candeiassantiago393-spec/PAP/elevador/hardware/README.md

# Hardware — Elevador

Documentação física do protótipo: componentes, esquemas e mecânica.

| Pasta | Conteúdo |
|---|---|
| [bom/](bom/) | Bill of Materials — lista de componentes |
| [esquemas/](esquemas/) | Esquemas elétricos (KiCad, Fritzing, PDF) |
| [mecanica/](mecanica/) | Estrutura madeira, cabine adaptada, tambor, fixações |

## Estado

| Área | Estado |
|---|---|
| BOM documentado | Parcial — ver [bom/componentes.md](bom/componentes.md) |
| Esquemas formais | [ELV-SCH-001/002](esquemas/) |
| Estrutura mecânica | Madeira + recipiente adaptado — [mecanica/](mecanica/) |
| Fotos mecânica | Pendente — [mecanica/imagens/](mecanica/imagens/) |

## Compras

Faturas e justificação: [docs/compras/](../../docs/compras/)

## Navegação

| | |
|--|--|
| Elevador | [../README.md](../README.md) |
| Maquete | [../maquete/ESTADO_ATUAL.md](../maquete/ESTADO_ATUAL.md) |
| Pinagem | [../documentacao/pinagem.md](../documentacao/pinagem.md) |
| Índice repo | [../../docs/INDICE_REPOSITORIO.md](../../docs/INDICE_REPOSITORIO.md) |
