candeiassantiago393-spec/PAP/elevador/maquete/README.md

# Maquete Física — Elevador

Registo visual e estado da montagem do protótipo real.

## Conteúdo

| Pasta | Uso |
|---|-----|
| [imagens/fotos/](imagens/fotos/) | Fotografias da maquete |
| [imagens/videos/](imagens/videos/) | Vídeos de progresso |
| [ESTADO_ATUAL.md](ESTADO_ATUAL.md) | Estado detalhado e próximos passos |

## Vídeos (2026-06-22)

| Ficheiro | Descrição |
|---|---|
| [2026-06-22_maquete_oled_displays_teste.mp4](imagens/videos/2026-06-22_maquete_oled_displays_teste.mp4) | 4 displays OLED testados na estrutura |
| [2026-06-22_maquete_botoes_leds_exteriores.mp4](imagens/videos/2026-06-22_maquete_botoes_leds_exteriores.mp4) | Botões + LEDs exteriores — **piso 3 com falha** |
| [2026-06-22_maquete_botoes_leds_displays.mp4](imagens/videos/2026-06-22_maquete_botoes_leds_displays.mp4) | Integração geral (WhatsApp) |

## Fotos

| Ficheiro | Descrição |
|---|---|
| [2026-06-22_guias_cabos_argolas.png](imagens/fotos/2026-06-22_guias_cabos_argolas.png) | Argolas brancas + braçadeiras como guias de cabo |

## Próximas capturas

- Sensores Hall A3144 instalados
- Motor + tambor integrados no shaft
- Vista geral do poço completo
- Correção botão/LED 3.º andar (evidência depois)

## Estado detalhado

[ESTADO_ATUAL.md](ESTADO_ATUAL.md)

## Navegação

| | |
|--|--|
| Elevador | [../README.md](../README.md) |
| Mecânica / motor | [../hardware/mecanica/](../hardware/mecanica/) |
| Apresentação | [../../docs/APRESENTACAO_CURSOR.md](../../docs/APRESENTACAO_CURSOR.md) |
| Etapa E08 | [../../docs/ETAPAS/relatorios/E08_montagem_maquete.md](../../docs/ETAPAS/relatorios/E08_montagem_maquete.md) |
