candeiassantiago393-spec/PAP/logicas_extras/codigo_predio/documentacao/README.md

# Documentação — Código Porta Prédio

| Ficheiro | Conteúdo |
|---|---|
| [funcionamento.md](funcionamento.md) | Fluxo PIN, servo, serial |
| [pinagem.md](pinagem.md) | Ligações Arduino Uno |
| [fluxogramas.md](fluxogramas.md) | Diagramas de fluxo — **por fazer** |

## Navegação

| | |
|--|--|
| Módulo | [../README.md](../README.md) |
