candeiassantiago393-spec/PAP/logicas_extras/estendal_inteligente/documentacao/README.md

# Documentação — Estendal Inteligente

| Ficheiro | Conteúdo |
|---|---|
| [funcionamento.md](funcionamento.md) | Lógica chuva → servo |
| [pinagem.md](pinagem.md) | Ligações Arduino Uno |
| [fluxogramas.md](fluxogramas.md) | Diagramas de fluxo — **por fazer** |

## Navegação

| | |
|--|--|
| Módulo | [../README.md](../README.md) |
