candeiassantiago393-spec/PAP/logicas_extras/estendal_inteligente/simulacao/README.md

# Simulação — Estendal Inteligente

Projecto Wokwi: [wokwi/](wokwi/)

## Compilar

```bash
cd logicas_extras/estendal_inteligente/simulacao/wokwi
python -m platformio run
```

Stop + Start no Wokwi após compilar.

## Teste

Mudar o slide switch para ON → servo recolhe → espera 8 s → reabre.

## Navegação

| | |
|--|--|
| Módulo | [../../README.md](../../README.md) |
