candeiassantiago393-spec/PAP/elevador/hardware/mecanica/imagens/README.md

# Imagens — Mecânica

| Ficheiro | Descrição | Data |
|---|---|---|
| [2026-06-22_motor_nema17_tambor_correia.png](2026-06-22_motor_nema17_tambor_correia.png) | NEMA 17 bipolar, correia dentada, tambor como polia (suporte metálico) | 2026-06-22 |

Motor cedido pelo professor (reutilizável). Testado na bancada com L298N — integração no shaft da maquete pendente.

## Por adicionar

- Motor montado no topo do poço
- Cabo de aço na cabine
- Fixação Hall por piso

## Navegação

| | |
|--|--|
| Mecânica | [../README.md](../README.md) |
| Maquete | [../../../maquete/ESTADO_ATUAL.md](../../../maquete/ESTADO_ATUAL.md) |
