candeiassantiago393-spec/PAP/elevador/hardware/mecanica/stl/README.md

# STL — Plano inicial (não utilizado)

> **Nota:** Este diretório reflecte o **plano inicial** de impressão 3D da cabine.  
> Na implementação final, a estrutura foi feita **à mão com madeira** e a cabine com um **recipiente adaptado**.  
> Ver [../README.md](../README.md) e [../imagens/](../imagens/) para o registo actual.

## Plano original (referência)

| Ficheiro | Descrição | Estado |
|---|---|---|
| `cabine_v1.stl` | Corpo da cabine | Não aplicável |
| `guia_cabine.stl` | Guias no shaft | Não aplicável |
| `suporte_hall.stl` | Fixação sensores | Não aplicável |

Mantido para histórico do projecto — caso no futuro se queira uma peça impressa (ex.: suporte Hall).

## Ligação

- [E08 — Montagem maquete](../../../../docs/ETAPAS/relatorios/E08_montagem_maquete.md)
- [Dimensionamentos_motor.docx](../../../../docs/relatorios/Dimensionamentos_motor.docx)
