candeiassantiago393-spec/PAP/elevador/maquete/imagens/fotos/README.md

# Fotos — Maquete

| Ficheiro | Descrição | Data |
|---|---|---|
| [2026-06-22_guias_cabos_argolas.png](2026-06-22_guias_cabos_argolas.png) | Argolas brancas parafusadas à estrutura + braçadeiras para guiar cabos | 2026-06-22 |

## Por adicionar

- Vista geral do shaft
- Hall A3144 por piso
- Motor/tambor integrado no topo
- Cabine + íman

## Navegação

| | |
|--|--|
| Maquete | [../../README.md](../../README.md) |
| Vídeos | [../videos/](../videos/) |
