candeiassantiago393-spec/PAP/logicas_extras/codigo_predio/simulacao/wokwi/README.md

# Wokwi — Cofre código secreto

Abrir **esta pasta** como raiz do projeto Wokwi no Cursor.

| Ficheiro | Uso |
|---|-----|
| `sketch.ino` | Firmware |
| `diagram.json` | Circuito virtual |
| `wokwi.toml` | Configuração Wokwi |
| `libraries.txt` | Servo, Keypad |

`F1` → **Wokwi: Start Simulator**
