candeiassantiago393-spec/PAP/docs/ETAPAS/relatorios/E12_logicas_extras.md

# E12 — Lógicas Extras do Prédio Inteligente

| Campo | Valor |
|---|---|
| **Estado** | Em curso (codigo_predio + painel ecra) |
| **Código** | `logicas_extras/` |

## Objetivo

Subsistemas do prédio além do elevador: segurança, RFID, meteorologia, porta, toldo, etc.

## Módulos planeados

| Módulo | Estado |
|---|---|
| **Código prédio** | Simulação Wokwi — [logicas_extras/codigo_predio/](../../logicas_extras/codigo_predio/) |
| Segurança | Inicial |
| Painéis controlo | **Simulação Wokwi** — [paineis_controlo/caixa_ecra](../../logicas_extras/paineis_controlo/simulacao/wokwi/) |
| Meteorologia | **Funcional no painel ecra** — [meteorologia](../../logicas_extras/meteorologia/) (KY-015, ecrãs AMBIENTE/GRÁFICO) |
| Porta prédio + código | Inicial (relacionado com codigo_predio) |
| RFID por andar | Inicial |
| Toldo automático (chuva) | Inicial |

## Prioridade

Após conclusão do elevador (E10).

## O que foi feito

### Código prédio — teclado + servo (Wokwi)

- Protótipo funcional: teclado 3×4, validação PIN, servo, LEDs e buzzer
- Código correcto de demonstração: `1904`
- Export integrado em `logicas_extras/codigo_predio/simulacao/wokwi/`
- Link: https://wokwi.com/projects/462220624733136897

Relacionado com a porta do prédio (mesma lógica de acesso por código).

### Painel ESP32 — caixa ecra (Wokwi)

- ESP32 + OLED SSD1306 — 6 ecrãs: HOME, ambiente (KY-015), movimento (PIR), plantas/estufa, gráfico temp, QR Instagram
- Modo feira (rotação auto), alertas Telegram opcionais
- Export: `logicas_extras/paineis_controlo/simulacao/wokwi/`
- PlatformIO: `logicas_extras/paineis_controlo/real/caixa_ecra/`
- Origem: projeto local **ecra** (candeias.dev)

Cobre [meteorologia](../../logicas_extras/meteorologia/) (ecrãs AMBIENTE + GRÁFICO) e [segurança](../../logicas_extras/seguranca/) (ecrã MOVIMENTO) na demonstração.

Documentação meteorologia: [funcionamento.md](../../logicas_extras/meteorologia/documentacao/funcionamento.md).

_(Outros módulos a documentar à medida que evoluem.)_

## Compras relacionadas

| Fatura | Total | Componentes |
|---|---|---|
| [2026EC1403323](../compras/faturas_mauser/2026EC1403323.md) | 29,62 € | ESP32, teclado, RFID, OLED protótipo |
| [2026EC1409725](../compras/faturas_mauser/2026EC1409725.md) | 47,18 € | T-Camera S3 (câmara + PIR) |

Ver [índice Mauser](../compras/faturas_mauser/_indice.md).
