candeiassantiago393-spec/PAP/elevador/maquete/ESTADO_ATUAL.md

# Estado Atual da Maquete

> Última atualização: 2026-07-06

## Fase do projeto

**Integração física na maquete** — I/O exterior e displays montados; motor testado em **bancada** (ainda não integrado na estrutura).

```text
[✓] Programar / projetar
[✓] Simulação virtual (v01–v06)
[✓] Testes de bancada (botões, LEDs, OLED, motor+L298N, Hall pendente teste casa)
[→] Montagem na maquete (I/O + cablagem)     ← ESTAMOS AQUI
[ ] Sensores Hall + íman na cabine
[ ] Motor + tambor na maquete
[ ] Testes sistema completo
[ ] Acabamentos (ventoinha L298N, porta/interiores se aplicável)
[ ] Decoração e visual moderno (papel autocolante, miniaturas interiores)
```

---

## Componentes montados na maquete

| Componente | Qtd | Estado | Notas |
|---|-----|---|---|
| Botões pedido exterior | 4 | Montado | **Piso 3 com falha** — ver [DIFICULDADES](../../docs/DIFICULDADES.md) |
| LEDs pedido exterior | 4 | Montado | Piso 3 a investigar (mau contacto?) |
| Displays OLED SH1106 | 4 | Montado | Testados em vídeo |
| Multiplexador TCA9548A | 1 | Montado | — |
| Guias de cabos (argolas) | várias | Montado | Braçadeiras + argolas brancas na estrutura |
| Estrutura madeira + cabine | 1 | Montado | Recipiente adaptado |

### Ainda fora da maquete (mas disponíveis)

| Componente | Estado |
|---|---|
| Motor NEMA 17 + tambor/polia + correia | Montagem mecânica feita; **testado na bancada** com 12 V; por integrar no shaft |
| Driver L298N | Testado na bancada (cedido tutor Manuel Queiroz) |
| Sensores Hall **A3144** ×4 | Montados — D7, D8, D11, D12 |
| Firmware maquete | [codigo_final_3_0_maquete/ext_porta](../real/codigo_final_3_0_maquete/ext_porta/) |
| Ventoinha 40 mm L298N | **Não comprada** |
| Botões/LEDs interiores | **Por decidir** — possível só apresentação virtual |
| Permissiva porta (D22) | **Chave deslizante** montada |

---

## Próximos passos (ordem)

1. **Testar Hall A3144** — `testes/bancada/hall_diag/` e `hall_sequencia/`
2. Confirmar cabos **OUT** dos sensores piso 1 e 2 (D7, D8)
3. Integrar **motor + tambor** no topo/shaft da maquete
4. Corrigir **botão/LED 3.º andar** (testes de continuidade)
5. Ventoinha no L298N (quando comprada)
6. Decidir se porta e botões interiores ficam físicos ou só na simulação Wokwi
7. **Sábado 2026-07-11:** comprar decorações — papel autocolante para revestimento exterior (visual moderno do prédio), bonecos e miniaturas para o interior dos apartamentos

---

## Decoração e acabamento visual (planeado)

| Item | Objetivo | Quando |
|---|---|---|
| Papel autocolante | Fachada e paredes com aspeto moderno (substituir madeira à vista) | Compra **sábado 11 jul** |
| Bonecos / figuras miniatura | Interior dos pisos — dar vida aos apartamentos na maquete | Compra **sábado 11 jul** |
| Outras decorações | Detalhes de ambiente (mobiliário em miniatura, plantas, etc.) | Compra **sábado 11 jul** |

> Aplicar decoração **após** cablagem e testes eléctricos principais, para não danificar acabamentos.

---

## Convenção de pisos

| Nome na maquete | Piso lógico firmware |
|---|---|
| **Rés-do-chão / 1.º andar** | Piso 1 (Hall **D7**, botão D2, etc.) |
| 2.º–4.º andar | Pisos 2–4 |

---

## Evidências (fotos e vídeos)

| Ficheiro | Descrição |
|---|---|
| [oled_displays_teste.mp4](imagens/videos/2026-06-22_maquete_oled_displays_teste.mp4) | 4 displays OLED a serem testados |
| [botoes_leds_exteriores.mp4](imagens/videos/2026-06-22_maquete_botoes_leds_exteriores.mp4) | Botões + LEDs exteriores — **piso 3 com problema** |
| [guias_cabos_argolas.png](imagens/fotos/2026-06-22_guias_cabos_argolas.png) | Argolas brancas + braçadeiras como guias de cabo |
| [motor_tambor_correia.png](../hardware/mecanica/imagens/2026-06-22_motor_nema17_tambor_correia.png) | NEMA 17, correia dentada, tambor como polia |

---

## Diferenças simulação ↔ maquete

| Aspeto | Wokwi v06 | Maquete |
|---|---|---|
| Driver | A4988 | L298N (D9, D33, D31, D32) |
| OLED | SSD1306 | SH1106 + TCA9548A |
| Sensor piso | Interruptor | Hall **A3144** (LOW = íman) |
| Motor | Stepper sim | NEMA 17 bipolar (4 fios) |
| Porta / interiores | Simulados | Possivelmente **só virtuais** na apresentação |

Pinagem completa: [documentacao/pinagem.md](../documentacao/pinagem.md)

---

## Notas de montagem

- 2026-06-22: I/O exterior + OLEDs integrados na estrutura madeira.
- Cablagem organizada com **braçadeiras** e **argolas** (tipo berço) parafusadas à maquete.
- Motor + tambor: conjunto mecânico pronto; alimentação 12 V validada **na bancada**, não no shaft.
- Lógicas extras (codigo_predio, ecra, toldo, RFID): **após elevador funcional** na maquete.
- 2026-07-06: Botões novos chegaram; testes de lógica do elevador em curso.
- 2026-07-11 (sábado): compra planead de papel autocolante, bonecos e decorações miniatura para acabamento visual da maquete.
