candeiassantiago393-spec/PAP/docs/compras/faturas_mauser/2026EC1403323.md

# Fatura 2026EC1403323

| Campo | Valor |
|---|---|
| **Fatura** | FT V201.04/26017707 |
| **Encomenda** | 2026EC1403323 |
| **Data** | 2026-02-06 |
| **Total** | **29,62 €** |
| **Etapa** | [E12 — Lógicas extras](../../ETAPAS/relatorios/E12_logicas_extras.md) |
| **PDF** | [2026EC1403323.pdf](2026EC1403323.pdf) |

## Itens

| Cód. | Designação | Qtd | Preço | Total | Módulo previsto |
|---|---|-----|---|---|---|
| 095-4900 | NodeMCU ESP32 USB-C | 1 | 9,39 € | 9,39 € | Lógicas extras / IoT |
| 096-4642 | Teclado matricial 3×4 | 1 | 4,07 € | 4,07 € | [porta_predio](../../../logicas_extras/porta_predio/) |
| 096-7806 | OLED 0,96" I2C | 1 | 3,83 € | 3,83 € | Protótipo / testes |
| 096-7946 | Placa protótipo photoshield | 1 | 2,36 € | 2,36 € | Bancada extras |
| 096-8517 | Leitor RFID RC522 13,56 MHz | 1 | 1,59 € | 1,59 € | [rfid](../../../logicas_extras/rfid/) |
| PORTES | Encargos logísticos | 1 | 2,84 € | 2,84 € | — |

## Justificação — componente e função

| Cód. | Componente | Função | Detalhe |
|---|---|---|---|
| 095-4900 | ESP32 NodeMCU | MCU Wi-Fi/BT para subsistemas do prédio | [logicas_extras.md](../justificacao/logicas_extras.md#módulo-nodemcu-esp32-usb-c-095-4900) |
| 096-4642 | Teclado 3×4 | Código de acesso à porta do prédio | [logicas_extras.md](../justificacao/logicas_extras.md#teclado-matricial-de-membrana-3×4-096-4642) |
| 096-7806 | OLED 0,96" | Display de protótipo para módulos extras | [logicas_extras.md](../justificacao/logicas_extras.md#ecrã-oled-096-128×64-i2c-096-7806) |
| 096-7946 | Photosheild | Bancada de prototipagem rápida | [logicas_extras.md](../justificacao/logicas_extras.md#placa-protótipo-photoshield-096-7946) |
| 096-8517 | RFID RC522 | Leitura de cartões de acesso | [logicas_extras.md](../justificacao/logicas_extras.md#módulo-leitor-rfid-rc522-1356-mhz-096-8517) |

## Ligação ao projeto

- [logicas_extras/](../../../logicas_extras/)
