candeiassantiago393-spec/PAP/docs/compras/faturas_mauser/2026EC1409725.md

# Fatura 2026EC1409725

| Campo | Valor |
|---|---|
| **Fatura** | FT V201.04/26021406 |
| **Encomenda** | 2026EC1409725 |
| **Data** | 2026-02-13 |
| **Total** | **47,18 €** |
| **Etapa** | [E12 — Lógicas extras](../../ETAPAS/relatorios/E12_logicas_extras.md) |
| **PDF** | [2026EC1409725.pdf](2026EC1409725.pdf) |

## Itens

| Cód. | Designação | Qtd | Preço | Total | Módulo previsto |
|---|---|-----|---|---|---|
| 095-5977 | LILYGO T-Camera S3 (ESP32 + câmara 5 MP + PIR) | 1 | 31,46 € | 31,46 € | [seguranca](../../../logicas_extras/seguranca/) |
| 095-5979 | Caixa protetora T-Camera S3 | 1 | 3,29 € | 3,29 € | Segurança |
| 095-5980 | Cabo PH2.0 → DuPont fêmea | 1 | 0,77 € | 0,77 € | Ligação |
| PORTES | Encargos logísticos | 1 | 2,84 € | 2,84 € | — |

## Justificação — componente e função

| Cód. | Componente | Função | Detalhe |
|---|---|---|---|
| 095-5977 | T-Camera S3 | Câmara + PIR para vigilância do prédio | [logicas_extras.md](../justificacao/logicas_extras.md#placa-lilygo-t-camera-s3--esp32--câmara-5-mp--pir-095-5977) |
| 095-5979 | Caixa T-Camera | Proteção mecânica do módulo | [logicas_extras.md](../justificacao/logicas_extras.md#caixa-protetora-t-camera-s3-095-5979) |
| 095-5980 | Cabo PH2.0 | Ligação periféricos da câmara | [logicas_extras.md](../justificacao/logicas_extras.md#cabo-ph20--dupont-fêmea-095-5980) |

## Ligação ao projeto

- [logicas_extras/seguranca/](../../../logicas_extras/seguranca/)
