candeiassantiago393-spec/PAP/docs/compras/faturas_mauser/2026EC1454381.md

# Fatura 2026EC1454381

| Campo | Valor |
|---|---|
| **Fatura** | FT V201.04/26047273 |
| **Encomenda** | 2026EC1454381 |
| **Data** | 2026-04-06 |
| **Total** | **46,79 €** |
| **Etapa** | [E07 — Testes de bancada](../../ETAPAS/relatorios/E07_testes_bancada.md) |
| **PDF** | [2026EC1454381.pdf](2026EC1454381.pdf) |

## Itens

| Cód. | Designação | Qtd | Preço | Total |
|---|---|-----|---|---|
| 035-0873 | Fonte industrial 12 VDC 5 A 60 W — Orno OR-ZL-1633 | 1 | 7,72 € | 7,72 € |
| 095-0403 | Kit 525 resistências 1/4 W 1% | 1 | 5,24 € | 5,24 € |
| 096-8737 | OLED 1,3" I2C branco (Arduino) | 4 | 5,56 € | 22,24 € |
| PORTES | Encargos logísticos | 1 | 2,84 € | 2,84 € |

## Justificação — componente e função

Cada item com a sua função no sistema. Detalhe completo em [justificacao/](../justificacao/).

| Cód. | Componente | Função | Justificação |
|---|---|---|---|
| 035-0873 | Fonte Orno 12 V 5 A | Alimentar motor (L298N) e malha de potência | [elevador.md](../justificacao/elevador.md#fonte-de-alimentação-industrial-12-vdc-5-a-60-w--orno-035-0873) |
| 095-0403 | Kit resistências | Limitar corrente em LEDs e circuitos auxiliares | [elevador.md](../justificacao/elevador.md#conjunto-525-resistências-14-w-1-095-0403) |
| 096-8737 | OLED 1,3" ×4 | Mostrar piso, fila, estado e emergência por andar | [elevador.md](../justificacao/elevador.md#módulo-ecrã-oled-13-i2c-branco-096-8737--×4-unidades) |

## Ligação ao projeto

- Elevador: fonte + OLEDs → [elevador/real/](../../../elevador/real/)
- Testes: [elevador/testes/bancada/](../../../elevador/testes/bancada/)
