candeiassantiago393-spec/PAP/docs/compras/faturas_mauser/_indice.md

# Índice — Faturas Mauser

| # | Encomenda | Fatura | Data | Total | Etapa | Ficheiro |
|---|---|---|---|---|---|---|
| 1 | [2026EC1403323](2026EC1403323.md) | FT V201.04/26017707 | 2026-02-06 | **29,62 €** | E12 | [PDF](2026EC1403323.pdf) |
| 2 | [2026EC1409725](2026EC1409725.md) | FT V201.04/26021406 | 2026-02-13 | **47,18 €** | E12 | [PDF](2026EC1409725.pdf) |
| 3 | [2026EC1454381](2026EC1454381.md) | FT V201.04/26047273 | 2026-04-06 | **46,79 €** | E07 | [PDF](2026EC1454381.pdf) |
| 4 | Loja Corroios | FR V602.04/26021664 | 2026-06-15 | **7,88 €** | E08 | [recibo](2026-06-15_FR26021664_recibo_mauser_corroios.png) |

**Total documentado:** 131,47 €

---

## Por etapa do projeto

### E07 — Bancada
| Componente | Código | Qtd | Valor | Fatura |
|---|---|-----|---|---|
| Fonte 12 VDC 5 A 60 W (Orno) | 035-0873 | 1 | 7,72 € | [2026EC1454381](2026EC1454381.md) |
| Kit 525 resistências 1/4 W | 095-0403 | 1 | 5,24 € | [2026EC1454381](2026EC1454381.md) |
| OLED 1,3" I2C branco | 096-8737 | 4 | 22,24 € | [2026EC1454381](2026EC1454381.md) |

### E08 — Maquete
| Componente | Código | Qtd | Valor | Fatura |
|---|---|-----|---|---|
| Fio cobre multifilar preto 25 m | 016-0210 | 1 | 3,55 € | [recibo Corroios](2026-06-15_FR26021664_recibo_mauser_corroios.png) |
| Fio cobre multifilar branco 25 m | 016-0211 | 1 | 2,56 € | [recibo Corroios](2026-06-15_FR26021664_recibo_mauser_corroios.png) |
| Manga termorretrátil amarela 1 m | 096-1690 | 1 | 0,30 € | [recibo Corroios](2026-06-15_FR26021664_recibo_mauser_corroios.png) |

### E12 — Lógicas extras
| Componente | Código | Qtd | Valor | Fatura |
|---|---|-----|---|---|
| NodeMCU ESP32 USB-C | 095-4900 | 1 | 9,39 € | [2026EC1403323](2026EC1403323.md) |
| Teclado matricial 3×4 | 096-4642 | 1 | 4,07 € | [2026EC1403323](2026EC1403323.md) |
| OLED 0,96" I2C (protótipo) | 096-7806 | 1 | 3,83 € | [2026EC1403323](2026EC1403323.md) |
| Placa protótipo photoshield | 096-7946 | 1 | 2,36 € | [2026EC1403323](2026EC1403323.md) |
| Leitor RFID RC522 | 096-8517 | 1 | 1,59 € | [2026EC1403323](2026EC1403323.md) |
| LILYGO T-Camera S3 (ESP32 + câmara) | 095-5977 | 1 | 31,46 € | [2026EC1409725](2026EC1409725.md) |
| Caixa T-Camera S3 | 095-5979 | 1 | 3,29 € | [2026EC1409725](2026EC1409725.md) |
| Cabo PH2.0 → DuPont | 095-5980 | 1 | 0,77 € | [2026EC1409725](2026EC1409725.md) |

---

## Pendente

- [ ] Mais faturas Mauser (jumpers, ponteiras, motor, L298N, Hall…)
- [x] Justificações técnicas — [justificacao/](../justificacao/) (componente + função)
