candeiassantiago393-spec/PAP/docs/relatorios/Dimensionamentos_motor.docx

Relatório Técnico Académico

Projeto de Protótipo de Elevador e Prédio Inteligente (4 Pisos)

1. Introdução e Especificações do Sistema

O presente relatório técnico tem como objetivo apresentar a memória descritiva e o dimensionamento mecânico e elétrico de um protótipo funcional de elevador integrado num edifício inteligente de quatro pisos, com controlo através de microcontrolador Arduino Mega 2560.

1.1 Premissas Físicas do Sistema

O sistema foi concebido com base nas seguintes especificações:

- Número de pisos: 4
- Curso total do elevador: 80 cm
- Altura entre pisos: 20 cm
- Massa máxima (carga desequilibrada): 0,6 kg
- Velocidade linear de operação: 0,10 m/s
- Condição crítica: ausência de contrapeso

Estas condições representam o pior cenário operacional, garantindo a máxima robustez no dimensionamento do sistema.

1.2 Arquitetura de Alimentação

O sistema utiliza uma arquitetura híbrida com separação funcional entre potência e lógica:

- Malha de Lógica:
  - Tensão: 5V DC
  - Alimentação via porta USB / barramento do Arduino Mega
- Malha de Potência:
  - Tensão: 12V DC
  - Fonte industrial de colmeia: Orno 12V, 5A (60W) — Modelo OR-ZL-1633

📌 Nota Técnica Importante:
Apesar da separação funcional das fontes, é utilizado obrigatoriamente um GND comum (referência de massa interligada entre o polo negativo da fonte Orno e o pino GND do Arduino). Esta interligação de massas é obrigatória para estabelecer o mesmo referencial nulo entre os dois circuitos. Sem este ponto comum, os transístores internos do circuito integrado L298N não conseguiriam interpretar corretamente os sinais de nível lógico Alto (5V) e Baixo (0V) provenientes dos pinos digitais do Arduino Mega, resultando em falhas de comutação e comportamento errático do motor.

2. Dimensionamento Mecânico (Física do Movimento)

2.1 Cálculo da Força Peso

A força exercida pela carga para vencer a gravidade é determinada pela equação fundamental:

F = m * g

Onde:

- m = 0,6 kg
- g = 9,81 m/s^2 (aceleração gravitacional padrão da Terra, baseada na massa e no raio médio do planeta)

F = 0,6 * 9,81 = 5,886 N

2.2 Potência Mecânica Útil

A potência mecânica instantânea necessária para o deslocamento vertical é:

P_u = F * v

P_u = 5,886 * 0,10 = 0,5886 W

Aplicando um Fator de Segurança (FS = 2,0) para mitigar o atrito estático nas calhas guia verticais e a inércia no arranque:

P_nominal = 0,5886 * 2 = 1,1772 W

2.3 Cálculo do Binário no Tambor

A relação entre a força peso e o torque necessário no eixo de tração é dada por:

T = F * r

Onde:

- r = 0,02 m (raio correspondente ao tambor de 4 cm diâmetro)

T = 5,886 * 0,02 = 0,11772 Nm

Efetuando a conversão para a unidade comercial padrão de motores de passo (1 Nm = 10,197 kgf.cm):

T = 0,11772 * 10,197 = 1,20 kgf.cm

Aplicando o Fator de Segurança (FS = 2,0):

T_seguranca = 2,40 kgf.cm

2.4 Justificação do Motor NEMA 17

O motor selecionado (NEMA 17 híbrido industrial recuperado) apresenta um torque típico de retenção entre 3,5 a 4,5 kgf·cm.

✅ Conclusão Técnica:

- O motor excede o requisito mínimo de segurança calculado (2,40 kgf·cm).
- Garante uma margem de segurança superior a 45% diretamente no eixo.
- O conjunto mecânico inclui uma correia síncrona que fornece uma redução mecânica adicional entre o eixo do motor e o tambor. Isto funciona como uma caixa de redução que multiplica o torque efetivo e reduz o esforço do motor.

📌 Nota Prática de Comissionamento (Identificação de Bobinas):
Por se tratar de um motor bipolar de quatro fios recuperado de equipamento industrial, a identificação dos pares de bobinas (Fase A e Fase B) deve ser realizada por ensaio de curto-circuito indutivo. Ao unir as extremidades de dois fios aleatórios e rodar manualmente o eixo do motor, a ocorrência de uma resistência mecânica severa (efeito de travagem por indução magnética) valida que esses fios pertencem à mesma fase, devendo ser conectados respetivamente aos bornes OUT1/OUT2 (Fase A) ou OUT3/OUT4 (Fase B) do driver L298N.

3. Dimensionamento Elétrico e Análise de Energia

3.1 Malha de Potência (12V DC)

Consumo do Motor através do estágio de potência:

- Corrente nominal por fase: 1,5 A
- Comutação: duas fases ativas simultaneamente (padrão de passos do código)

P = V * I = 12 * 1,5 = 18 W

3.2 Validação da Fonte de Alimentação

A fonte escolhida foi o modelo industrial Orno OR-ZL-1633.

Parâmetro | Valor
Tensão | 12V DC (Regulada)
Corrente Máxima | 5 A
Potência Máxima | 60 W

Cálculo da margem de capacidade da fonte (Folga):

Folga = 60W / 18W = 3,33

✅ Conclusão:
A fonte disponibiliza mais de 300% de capacidade em relação ao consumo do motor, operando num regime térmico confortável e oferecendo total imunidade a quedas de tensão causadas por picos de corrente no arranque.

3.3 Malha de Lógica (5V DC)

Análise do somatório de consumo dos periféricos associados ao Arduino Mega 2560:

Dispositivo / Periférico | Corrente Estimada (mA)
Arduino Mega 2560 (Placa) | 50 mA
4x Displays OLED SH1106 (4 * 20 mA) | 80 mA
LEDs Indicadores (Média de acesos) | 75 mA
Sensores Hall de Piso e Porta (5 * 5 mA) | 25 mA
Buzzer Piezoelétrico (Pico ativo) | 30 mA
Total da Malha de Lógica | 260 mA

Cálculo da potência da malha lógica:

P = 5V * 0,26A = 1,3 W

✅ Conclusão:
A corrente total exigida (260 mA) é substancialmente inferior ao limite standard fornecido por uma porta USB de computador (500 mA). O barramento de 5V do Arduino Mega possui capacidade para estabilizar todos os componentes com segurança.

3.4 Análise Termodinâmica da Energia

📌 Importante:
A potência mecânica útil (1,18 W) jamais deve ser somada à potência elétrica total das fontes (19,5 W). Na física, a potência mecânica é o resultado direto da conversão da energia elétrica disponível.

P_eletrica = P_mecanica + P_perdas

A diferença entre os 18W elétricos injetados na malha de potência e os 1,18W de trabalho mecânico útil representa a ineficiência do sistema, sendo totalmente dissipada sob a forma de calor nas bobinas do motor e nos semicondutores do driver.

4. Comportamento Térmico e Análise do Driver L298N

4.1 Limitações Tecnológicas

O circuito integrado L298N é baseado numa tecnologia de transístores bipolares de junção em configuração Darlington. Esta arquitetura antiga introduz uma resistência interna significativa, gerando uma queda de tensão interna estável entre 2V e 2,5V.

A tensão efetiva que chega aos terminais do motor é de:

V_motor = 12V - 2,5V = 9,5V

✅ Conclusão Técnica:
Apesar da perda de tensão, o motor mantém torque suficiente para a operação devido à leveza da cabine e ao auxílio da redução mecânica por correia.

4.2 Dissipação Térmica

Multiplicando a queda de tensão (2,5V) pela corrente nominal (1,5A), o chip gera uma dissipação contínua de:

P_perdas = 3.75 W

⚠️ Requisito Crítico de Segurança:
Para evitar que o driver ative a sua proteção térmica interna e desarme o elevador, é obrigatória a instalação de uma ventoinha (cooler) de arrefecimento ativo de 12V.

- Posicionamento: Fixada a 1 ou 2 cm de distância, soprando ar diretamente nas aletas do dissipador de alumínio do L298N.
- Ligação Elétrica: Conectada em paralelo diretamente nos bornes de entrada de potência (VCC e GND) do módulo L298N. Desta forma, o fluxo de ar inicia-se de forma automática assim que a fonte industrial Orno é ligada à tomada.

4.3 Gestão Inteligente de Energia via Software

Como estratégia de conservação energética e alívio térmico, o código fonte do Arduino implementa a função:

desligaBobinasMotor()

Esta função corta a corrente nas pontes H sempre que o elevador atinge o estado de paragem prolongada nos pisos (aguardando temporização ou novos comandos). Isto zera o consumo de corrente do motor em repouso, permitindo o arrefecimento rápido do driver L298N e prolongando a vida útil dos componentes.

5. Conclusões

O desenvolvimento deste estudo valida que o protótipo do prédio inteligente se encontra corretamente dimensionado:

- ✅ Mecânica: O binário exigido está acautelado pelo torque nativo do motor NEMA 17 e otimizado pela redução por correia.
- ✅ Elétrica: A fonte Orno de 60W trabalha com folga industrial superior a 300%, eliminando quaisquer riscos de sobrecarga.
- ✅ Lógica: A malha de controlo a 5V consome apenas 260mA, garantindo a estabilidade operacional do Arduino Mega e dos displays OLED.
- ✅ Térmica: As limitações térmicas do driver L298N foram totalmente mitigadas através da inclusão da ventoinha dedicada e da rotina de software para desligar as bobinas em repouso.
