candeiassantiago393-spec/PAP/docs/relatorios/Relatorio_Elevador_Inteligente.docx

Relatório Técnico Académico

Projeto de Protótipo de Elevador e Prédio Inteligente (4 Pisos)

1. Introdução e Especificações do Sistema

O presente relatório técnico tem como objetivo apresentar a memória descritiva e o dimensionamento mecânico e elétrico de um protótipo funcional de elevador integrado num edifício inteligente de quatro pisos, com controlo através de microcontrolador Arduino Mega 2560.

1.1 Premissas Físicas do Sistema

O sistema foi concebido com base nas seguintes especificações:

- Número de pisos: 4

- Curso total do elevador: 80 cm

- Altura entre pisos: 20 cm

- Massa máxima: 0,6 kg

- Velocidade linear: 0,10 m/s

- Condição crítica: ausência de contrapeso

1.2 Arquitetura de Alimentação

Sistema com separação entre lógica (5V) e potência (12V).

Nota Técnica Importante:

Apesar da separação funcional, é utilizado um GND comum.

Esta interligação de massas (GND Comum) é obrigatória para estabelecer o mesmo referencial nulo entre os dois circuitos. Sem este ponto comum, os transístores internos do circuito integrado L298N não conseguiriam interpretar corretamente os sinais de nível lógico Alto (5V) e Baixo (0V) provenientes dos pinos digitais do Arduino Mega, resultando em falhas de comutação e comportamento errático do motor.

2. Dimensionamento Mecânico

2.1 Força Peso

F = m · g = 0,6 × 9,81 = 5,886 N

2.2 Potência Mecânica

Pu = F · v = 0,5886 W

Pnominal ≈ 1,18 W

2.3 Torque

τ = 0,11772 Nm ≈ 1,20 kgf·cm

τ_segurança = 2,40 kgf·cm

2.4 Motor NEMA 17

Torque típico: 3,5 a 4,5 kgf·cm

Nota Prática de Comissionamento (Identificação de Bobinas): Por se tratar de um motor bipolar de quatro fios recuperado de equipamento industrial, a identificação dos pares de bobinas (Fase A e Fase B) deve ser realizada por ensaio de curto-circuito indutivo. Ao unir as extremidades de dois fios aleatórios e rodar manualmente o eixo do motor, a ocorrência de uma resistência mecânica severa valida que esses fios pertencem à mesma fase.

3. Dimensionamento Elétrico

3.1 Potência

P = 12 × 1,5 = 18 W

3.3 Lógica

Total ≈ 260 mA (1,3 W)

4. Comportamento Térmico

4.2 Dissipação

P ≈ 3–4 W

⚠️ Ventoinha deve ser ligada em paralelo diretamente nos bornes de entrada de potência (VCC e GND) do módulo L298N. Desta forma, o fluxo de ar inicia-se automaticamente.

5. Conclusões

Sistema validado e seguro.
