candeiassantiago393-spec/PAP/docs/README.md

# Documentação — PAP Prédio Inteligente

Índice central da documentação do repositório.

## Começar aqui

| Documento | Para quê |
|---|---|
| [INDICE_REPOSITORIO.md](INDICE_REPOSITORIO.md) | **Mapa completo** — todas as pastas interligadas |
| [CONTEXTO_PROJETO.md](CONTEXTO_PROJETO.md) | Histórico, versões, pinagem, estados |
| [ETAPAS/README.md](ETAPAS/README.md) | Cronologia E00–E12 com links ao código |
| [TASKS_PAP_SYNC.md](TASKS_PAP_SYNC.md) | Tasks do projeto (sync Candeias Control App) |
| [APRESENTACAO_CURSOR.md](APRESENTACAO_CURSOR.md) | Guia demo no Cursor (17 julho) |
| [DIFICULDADES.md](DIFICULDADES.md) | Problemas e soluções registados |

## Relatórios e especificação

| Pasta | Conteúdo |
|---|---|
| [relatorios/Relatorio_Especificacao_PAP_Predio_Inteligente_v4.pdf](relatorios/Relatorio_Especificacao_PAP_Predio_Inteligente_v4.pdf) | **Documento de referência do projeto final** — Relatório Técnico + DET v4.0, cobre elevador + lógicas extra + interfaces auxiliares |
| [relatorios/](relatorios/) | Restantes PDFs e DOCX (especificações parciais, dimensionamentos) |
| [ETAPAS/relatorios/](ETAPAS/relatorios/) | Relatório por fase do projeto |

## Compras

| Pasta | Conteúdo |
|---|---|
| [compras/](compras/) | Índice de faturas Mauser |
| [compras/justificacao/](compras/justificacao/) | Função de cada componente |
| [compras/faturas_mauser/_indice.md](compras/faturas_mauser/_indice.md) | Componente ↔ fatura ↔ etapa |

## Ligação ao código

| Área | Pasta |
|---|---|
| Elevador | [../elevador/](../elevador/) |
| Lógicas extras | [../logicas_extras/](../logicas_extras/) |
| Interface organização | [../interface/](../interface/) |

## Raiz do repo

[README.md](../README.md)
