candeiassantiago393-spec/PAP/logicas_extras/README.md

# Lógicas Extras — Prédio Inteligente

Subsistemas do prédio inteligente **além do elevador**.

## Módulos

| Pasta | Função | Estado |
|---|---|---|
| [cartoes_predio/](cartoes_predio/) | Cartões RFID — acesso por andar | Inicial |
| [central_de_controlo/](central_de_controlo/) | Caixa ESP32 OLED (ambiente, PIR, estufa, gás, fogo, sismo) | **Simulação Wokwi** |
| [codigo_predio/](codigo_predio/) | Código PIN porta prédio (teclado + servo) | **Simulação Wokwi** |
| [estendal_inteligente/](estendal_inteligente/) | Estendal por sensor de chuva | **Simulação Wokwi** |
| [legacy/](legacy/) | Versões antigas | — |

## Estrutura por módulo

```text
<nome_modulo>/
├── README.md           → visão geral do módulo
├── documentacao/       → funcionamento.md, pinagem.md, fluxogramas.md
├── simulacao/          → wokwi/ quando aplicável
├── real/               → montagem física: pinagem.md, notas, fotos/, código PlatformIO
└── testes/             → registo + código de bancada (PlatformIO)
    └── bancada/        → testes isolados por componente (quando aplicável)
```

## Registo diário (bancada)

| Data | Ficheiro |
|---|---|
| 2026-07-11 | [central_de_controlo/testes/bancada/REGISTO_2026-07-11.md](central_de_controlo/testes/bancada/REGISTO_2026-07-11.md) |
| 2026-07-12 | [central_de_controlo/testes/bancada/REGISTO_2026-07-12.md](central_de_controlo/testes/bancada/REGISTO_2026-07-12.md) |

## Testes de bancada

Cada módulo com hardware tem `testes/` com registo e, à medida que se monta, pastas `testes/bancada/<componente>/` (padrão igual ao elevador).

| Módulo | Primeiro teste |
|---|---|
| Central de controlo | [central_de_controlo/testes/bancada/dht_oled/](central_de_controlo/testes/bancada/dht_oled/) — KY-015 · [dht_gas_oled_next_buzzer/](central_de_controlo/testes/bancada/dht_gas_oled_next_buzzer/) — junção · [fire_oled/](central_de_controlo/testes/bancada/fire_oled/) — KY-026 |

## Compilar / simular

| Módulo | Comando |
|---|---|
| Central de controlo | `cd central_de_controlo && pio run` → Wokwi |
| Dashboard bancada | [central_de_controlo/scripts/run_dashboard.ps1](central_de_controlo/scripts/run_dashboard.ps1) |
| Código porta prédio | `cd codigo_predio/simulacao/wokwi && pio run` → Wokwi |
| Estendal | `cd estendal_inteligente/simulacao/wokwi && pio run` → Wokwi |

## Prioridade

1. Concluir elevador na maquete
2. Montar lógicas extras na apresentação (17 julho)
3. Preencher `real/` e `testes/` à medida que se monta hardware

## Navegação

| | |
|--|--|
| Índice repo | [../docs/INDICE_REPOSITORIO.md](../docs/INDICE_REPOSITORIO.md) |
| Elevador | [../elevador/README.md](../elevador/README.md) |
| Etapa E12 | [../docs/ETAPAS/relatorios/E12_logicas_extras.md](../docs/ETAPAS/relatorios/E12_logicas_extras.md) |
| Raiz PAP | [../README.md](../README.md) |
