candeiassantiago393-spec/PAP/elevador/README.md

# Elevador — Sistema Principal PAP

Elevador didático de 4 pisos. Arduino Mega, fila de pedidos, OLEDs, segurança e rearme.

## Segmentação

| Pasta | Conteúdo |
|---|---|
| [simulacao/](simulacao/) | Versões Tinkercad e Wokwi (legacy + exports) |
| [real/](real/) | Firmware maquete — [completo](real/codigo_final_3_0/) + [maquete/ext_porta](real/codigo_final_3_0_maquete/ext_porta/) |
| [testes/](testes/) | Bancada — validação isolada de hardware |
| [maquete/](maquete/) | Montagem física, fotos, estado actual |
| [documentacao/](documentacao/) | [pinagem](documentacao/pinagem.md) · [estados](documentacao/estados_sistema.md) |
| [hardware/](hardware/) | Esquemas · BOM |

## Firmware de referência

| Ambiente | Pasta |
|---|---|
| Simulação | [simulacao/legacy/wokwi/v06_atual_pedidos_internos_porta/](simulacao/legacy/wokwi/v06_atual_pedidos_internos_porta/) |
| Maquete (activo) | [real/codigo_final_3_0_maquete/ext_porta/](real/codigo_final_3_0_maquete/ext_porta/) |
| Completo (congelado) | [real/codigo_final_3_0/](real/codigo_final_3_0/) |

## Fase actual

Montagem na maquete — [maquete/ESTADO_ATUAL.md](maquete/ESTADO_ATUAL.md)

## Navegação

| | |
|--|--|
| Índice repo | [../docs/INDICE_REPOSITORIO.md](../docs/INDICE_REPOSITORIO.md) |
| Contexto | [../docs/CONTEXTO_PROJETO.md](../docs/CONTEXTO_PROJETO.md) |
| Etapas | [../docs/ETAPAS/README.md](../docs/ETAPAS/README.md) |
