candeiassantiago393-spec/PAP/docs/relatorios/README.md

# Relatórios e documentos base

Documentos Word/PDF do projeto, migrados do repo legado e de trabalho local.

## Documento de referência do projeto final

| Ficheiro | Descrição | Etapa |
|---|---|---|
| [Relatorio_Especificacao_PAP_Predio_Inteligente_v4.pdf](Relatorio_Especificacao_PAP_Predio_Inteligente_v4.pdf) | **Relatório Técnico + DET v4.0 (documento único e definitivo)** — cobre a totalidade do projeto: elevador, lógicas extra (central de controlo, código da porta, estendal inteligente) e interfaces auxiliares (dashboard Python, app de tasks). Entrega: 17/07/2026. Substitui/consolida as especificações parciais abaixo. | E00–E12 |

## Documentos parciais e legados (elevador)

| Ficheiro | Descrição | Etapa |
|---|---|---|
| [Relatorio_Especificacao_Elevador.pdf](Relatorio_Especificacao_Elevador.pdf) | Especificação técnica v3.0 (apenas elevador) | E00 |
| [Relatorio_Elevador_Inteligente.docx](Relatorio_Elevador_Inteligente.docx) | Relatório geral do elevador | E00 |
| [Dimensionamentos_motor.docx](Dimensionamentos_motor.docx) | Dimensionamento do motor | E00 |

### Tinkercad (fase inicial)

| Ficheiro | Descrição | Etapa |
|---|---|---|
| [tinkercad/Elevador_PaP_v01.pdf](tinkercad/Elevador_PaP_v01.pdf) | Relatório v01 | E01 |
| [tinkercad/relatorio_melhoria_codigo_v02.pdf](tinkercad/relatorio_melhoria_codigo_v02.pdf) | Melhorias de código v02 | E02 |
