candeiassantiago393-spec/PAP/logicas_extras/cartoes_predio/documentacao/README.md

# Documentação — Cartões de Prédio

| Ficheiro | Conteúdo |
|---|---|
| [funcionamento.md](funcionamento.md) | Lógica de autorização e fluxo |
| [pinagem.md](pinagem.md) | Ligações RC522 ↔ ESP32 (planeado) |
| [fluxogramas.md](fluxogramas.md) | Diagramas de fluxo — **por fazer** |

## Navegação

| | |
|--|--|
| Módulo | [../README.md](../README.md) |
| Lógicas extras | [../../README.md](../../README.md) |
