candeiassantiago393-spec/PAP/logicas_extras/central_de_controlo/documentacao/README.md

# Documentação — Central de Controlo

| Ficheiro | Conteúdo |
|---|---|
| [funcionamento.md](funcionamento.md) | Ecrãs, alarmes, prioridades, estufa |
| [pinagem.md](pinagem.md) | GPIO ESP32 completo |
| [fluxogramas.md](fluxogramas.md) | Diagramas de fluxo — **por fazer** |

## Navegação

| | |
|--|--|
| Módulo | [../README.md](../README.md) |
| Lógicas extras | [../../README.md](../../README.md) |
