candeiassantiago393-spec/PAP/logicas_extras/cartoes_predio/simulacao/README.md

# Simulação — Cartões de Prédio

Protótipo offline antes da montagem com RC522 físico.

## Estado

**Pendente** — ainda não há projecto Wokwi. Opções:

| Abordagem | Descrição |
|---|---|
| Wokwi + mock | Simular UID por botão / Serial |
| Teste Serial | Firmware mínimo que imprime UID sem simulador |

## Referência

Documentação: [../documentacao/funcionamento.md](../documentacao/funcionamento.md)
