candeiassantiago393-spec/PAP/elevador/maquete/imagens/README.md

# Imagens e vídeos — Maquete

| Pasta | Conteúdo |
|---|---|
| [fotos/](fotos/) | Fotografias fixas |
| [videos/](videos/) | Progresso em vídeo |

Índice completo: [maquete/README.md](../README.md) · [ESTADO_ATUAL.md](../ESTADO_ATUAL.md)
