candeiassantiago393-spec/PAP/logicas_extras/central_de_controlo/real/versoes/dht_gas_oled_next_buzzer/README.md

# Junção — dht + gas + oled + next + buzzer

| Campo | Valor |
|---|---|
| Componentes | KY-015, MQ (AO A1), OLED SSD1306, BTN NEXT, buzzer |
| Plataforma | Arduino Mega 2560 |
| Gás | Só **AOUT → A1** (igual firmware completo) |

## Versões

| Versão | Data | Notas |
|---|---|---|
| [v2](v2/) | 2026-07-13 | Telemetria JSON (dashboard), refresh OLED otimizado, warmup MQ no ecrã |
| [v1](v1/) | 2026-07-13 | Primeira junção combinada — HOME, GRAFICOS, BARRAS, GAS, alarme buzzer |

## Actual

**v2** está em [`../../atual/`](../../atual/) — versão real mais recente aprovada.

## Origem

Desenvolvido em [../../../testes/bancada/dht_gas_oled_next_buzzer/](../../../testes/bancada/dht_gas_oled_next_buzzer/).
