candeiassantiago393-spec/PAP/docs/ETAPAS/relatorios/E10_comissionamento.md

# E10 — Comissionamento Final

| Campo | Valor |
|---|---|
| **Estado** | Pendente |

## Objetivo

Sistema completo na maquete a funcionar com todos os subsistemas integrados.

## Critérios de aceitação

- [ ] 4 pisos com deteção Hall fiável
- [ ] Pedidos interior + exterior + fila por sentido
- [ ] OLEDs mostram estado correcto
- [ ] Porta bloqueia movimento
- [ ] Emergência + reset + rearme testados
- [ ] Movimento suave cabine + tambor

## O que foi feito

_(a preencher)_

## Dificuldades

_(a preencher)_

## Evidências

_(vídeo sistema completo, logs)_
