candeiassantiago393-spec/PAP/docs/ETAPAS/relatorios/E11_apresentacao.md

# E11 — Relatório e Apresentação

| Campo | Valor |
|---|---|
| **Estado** | Pendente |

## Objetivo

Defesa da PAP com demonstração integral no Cursor.

## Plano de apresentação

Ver [APRESENTACAO_CURSOR.md](../../APRESENTACAO_CURSOR.md)

- Workspace PAP no Explorer
- Evolução v01→v06
- Wokwi v06 ao vivo
- Vídeo/fotos maquete
- Interface de organização (geral-controll-app)
- Apresentação 3D _(fase posterior)_

## O que foi feito

- Guia de apresentação criado
- Repo reorganizado para demo única

## Próximo passo

- Migrar PDF relatório para `docs/relatorios/`
- Ensaiar ordem de demo 5–10 min
