candeiassantiago393-spec/PAP/docs/compras/faturas_mauser/2026-06-15_recibo_corroios.md

# Recibo Mauser — Corroios (cablagem maquete)

| Campo | Valor |
|---|---|
| **Documento** | FR V602.04/26021664 |
| **Data** | 2026-06-15 |
| **Loja** | Mauser — Corroios |
| **Total** | **7,88 €** |
| **Etapa** | [E08 — Montagem maquete](../../ETAPAS/relatorios/E08_montagem_maquete.md) |
| **Imagem** | [recibo](2026-06-15_FR26021664_recibo_mauser_corroios.png) |

## Itens

| Cód. | Designação | Qtd | Total líquido |
|---|---|-----|---|
| 096-1690 | Manga termorretrátil 1 m Ø2,4 mm amarela | 1 | 0,30 € |
| 016-0210 | Bobine fio cobre multifilar preto 25 m (0,14 mm²) | 1 | 3,55 € |
| 016-0211 | Bobine fio cobre multifilar branco 25 m (0,14 mm²) | 1 | 2,56 € |

## Justificação — componente e função

| Cód. | Componente | Função | Detalhe |
|---|---|---|---|
| 016-0210 | Fio preto 25 m | Cablagem fiável na maquete (comprimento adequado) | [elevador.md](../justificacao/elevador.md#bobine-fio-cobre-multifilar-preto-25-m--014-mm²-016-0210) |
| 016-0211 | Fio branco 25 m | Par identificado para retorno/GND/sinais | [elevador.md](../justificacao/elevador.md#bobine-fio-cobre-multifilar-branco-25-m--014-mm²-016-0211) |
| 096-1690 | Termorretrátil | Isolar junções — evitar mau contacto | [elevador.md](../justificacao/elevador.md#manga-termorretrátil-amarela-1-m-096-1690) |

## Ligação ao projeto

- [DIFICULDADES.md](../../DIFICULDADES.md) — entrada maquete/cablagem
- [elevador/maquete/](../../../elevador/maquete/)
