candeiassantiago393-spec/PAP/elevador/real/legacy/README.md

# Firmware real — legacy

| Pasta | Substituído por |
|---|---|
| [l298n_sh1106_hall/](l298n_sh1106_hall/) | [codigo_final_3_0/](../codigo_final_3_0/) (arquivo congelado) |

Voltar: [../README.md](../README.md)
