candeiassantiago393-spec/PAP/elevador/simulacao/legacy/README.md

# Legacy — Simulação

Versões históricas do firmware em ambiente virtual.

| Pasta | Versões |
|---|---|
| [tinkercad/](tinkercad/) | v01, v02 — Arduino Uno, motor DC |
| [wokwi/](wokwi/) | v03–v06 — Arduino Mega, stepper, OLED |

## Versão de referência

**v06** — [wokwi/v06_atual_pedidos_internos_porta/](wokwi/v06_atual_pedidos_internos_porta/)

## Etapas

[E01–E06](../../../docs/ETAPAS/README.md)
