candeiassantiago393-spec/PAP/elevador/simulacao/legacy/tinkercad/README.md

# Simulação Tinkercad — Elevador

Versões iniciais no Tinkercad com **Arduino Uno** e motor **DC**.

| Versão | Pasta | Plataforma |
|---|---|---|
| v01 | [v01_uno_motor_dc_lcd](v01_uno_motor_dc_lcd/) | Prova de conceito |
| v02 | [v02_fila_pedidos](v02_fila_pedidos/) | Fila de pedidos |

## Ligação às etapas

| Etapa | Versão |
|---|---|
| [E01](../../../../docs/ETAPAS/relatorios/E01_tinkercad_v01.md) | v01 |
| [E02](../../../../docs/ETAPAS/relatorios/E02_tinkercad_v02.md) | v02 |
