candeiassantiago393-spec/PAP/logicas_extras/legacy/README.md

# Legacy — Lógicas Extras

Arquivo de **versões antigas** ou protótipos substituídos.

## Quando usar

Quando um módulo evoluir, mover a versão anterior para aqui:

```text
legacy/
├── central_de_controlo_v1/
├── cofre_arduino_only/
└── ...
```

## Conteúdo actual

| Item | Origem | Notas |
|---|---|---|
| _(vazio)_ | — | Nenhum código legado migrado ainda |

## Navegação

| | |
|--|--|
| Lógicas extras | [../README.md](../README.md) |
| Índice repo | [../../docs/INDICE_REPOSITORIO.md](../../docs/INDICE_REPOSITORIO.md) |
