candeiassantiago393-spec/PAP/elevador/real/legacy/l298n_sh1106_hall/README.md

# Firmware real — L298N + SH1106 + Hall (LEGACY)

> **Movido para** [codigo_final_3_0/](../../codigo_final_3_0/) — versão completa arquivada (não alterar).

Esta pasta mantém-se só como referência histórica. Usar:

| Objetivo | Pasta |
|---|---|
| Versão completa congelada | [codigo_final_3_0/](../../codigo_final_3_0/) |
| Maquete activa (sem OLED, com porta) | [codigo_final_3_0_maquete/ext_porta/](../../codigo_final_3_0_maquete/ext_porta/) |
