candeiassantiago393-spec/PAP/docs/compras/faturas_mauser/2026-06-15_FR26021664_recibo_mauser_corroios.png

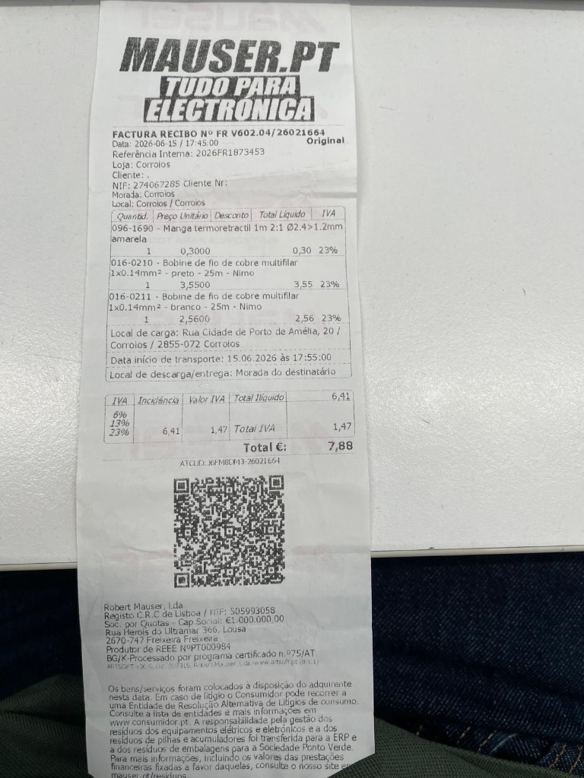
docs/compras/faturas_mauser/2026-06-15_FR26021664_recibo_mauser_corroios.png
