candeiassantiago393-spec/PAP/elevador/maquete/imagens/fotos/2026-06-22_guias_cabos_argolas.png

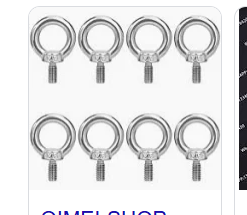
elevador/maquete/imagens/fotos/2026-06-22_guias_cabos_argolas.png
