candeiassantiago393-spec/PAP/logicas_extras/codigo_predio/tranca_keypad_arduino/imagem_2026-05-02_144628303.png

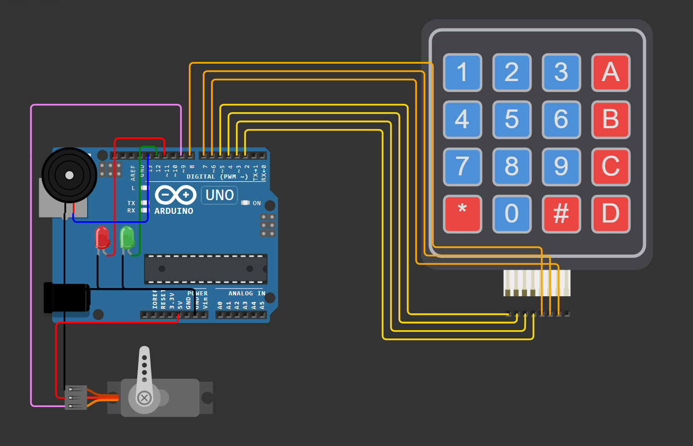
logicas_extras/codigo_predio/tranca_keypad_arduino/imagem_2026-05-02_144628303.png
