candeiassantiago393-spec/PAP/elevador/hardware/bom/README.md

# BOM — Elevador

Bill of Materials do subsistema elevador.

| Ficheiro | Descrição |
|---|---|
| [componentes.md](componentes.md) | Lista completa com função, quantidade e faturas |

Justificação detalhada: [docs/compras/justificacao/elevador.md](../../../docs/compras/justificacao/elevador.md)
