candeiassantiago393-spec/PAP/elevador/hardware/bom/componentes.md

# Componentes — Elevador

| Componente | Qtd | Função | Estado / origem | Fatura / nota |
|---|-----|---|---|---|
| Arduino Mega 2560 | 1 | Controlador principal | Em uso | — |
| Fonte 12 VDC 5 A 60 W (Orno 035-0873) | 1 | Alimentação motor + lógica | Comprado | [2026EC1454381](../../../docs/compras/faturas_mauser/2026EC1454381.md) |
| OLED 1,3" I2C SH1106 (096-8737) | 4 | Display por piso | Comprado | [2026EC1454381](../../../docs/compras/faturas_mauser/2026EC1454381.md) |
| Multiplexador TCA9548A | 1 | 4 OLEDs no mesmo I2C | Montado na maquete | _fatura pendente_ |
| Motor passo NEMA 17 bipolar | 1 | Movimento vertical cabine | **Cedido pelo professor** (reutilizável) | Tambor + correia — ver [mecanica/imagens/](../mecanica/imagens/) |
| Driver L298N | 1 | Acionamento bobinas motor | **Cedido pelo tutor Manuel Queiroz** | Testado na bancada 12 V |
| Sensor Hall **A3144** (TO-92) | 4 | Deteção de piso | Em uso — íman cabine pendente | _fatura pendente_ |
| Botões pedido exterior | 4 | Chamada por piso | Montado — **piso 3 a corrigir** | — |
| Botões pedido interior | 4 | Chamada na cabine | **Por decidir** (possível só virtual) | — |
| LEDs pedido exterior | 4 | Indicação pedido activo | Montado — piso 3 a corrigir | — |
| LEDs pedido interior | 4 | Indicação pedido activo | Por decidir | — |
| Buzzer | 1 | Bip chegada / alarme | Pendente montagem | — |
| Botão reset | 1 | Rearme após erro | Pendente montagem | — |
| Ventoinha 40 mm | 1 | Arrefecer L298N | **Não comprada** | Previsto |
| Argolas guia cabos | várias | Organização cablagem na maquete | Montado | Tipo berço, parafusadas à estrutura |
| Kit resistências 1/4 W (095-0403) | 1 | LEDs e auxiliares | Comprado | [2026EC1454381](../../../docs/compras/faturas_mauser/2026EC1454381.md) |
| Fio cobre preto 25 m (016-0210) | 1 | Cablagem maquete | Comprado | [recibo Corroios](../../../docs/compras/faturas_mauser/2026-06-15_recibo_corroios.md) |
| Fio cobre branco 25 m (016-0211) | 1 | Cablagem maquete | Comprado | [recibo Corroios](../../../docs/compras/faturas_mauser/2026-06-15_recibo_corroios.md) |
| Manga termorretrátil (096-1690) | 1 | Isolar junções | Comprado | [recibo Corroios](../../../docs/compras/faturas_mauser/2026-06-15_recibo_corroios.md) |
| Jumpers / ponteiras | — | Ligações fiáveis | Parcial | _faturas pendentes_ |
| Estrutura shaft (madeira) | 1 | Poço 4 pisos — construção manual | Montado | — |
| Cabine (recipiente adaptado) | 1 | Compartimento passageiros | Montado | — |
| Tambor + correia + cabo de aço | 1 | Transmissão motor → cabine | Tambor/polia montado; integração no shaft pendente | [foto motor](../mecanica/imagens/2026-06-22_motor_nema17_tambor_correia.png) |

**Total documentado em faturas (elevador):** ver [docs/compras/faturas_mauser/_indice.md](../../../docs/compras/faturas_mauser/_indice.md)
