candeiassantiago393-spec/PAP/logicas_extras/codigo_predio/testes/README.md

# Testes — Código Porta Prédio

Registo de testes na bancada e na maquete.

## Estado

**Pendente** — simulação Wokwi validada; testes físicos por documentar.

## Testes planeados

| ID | Teste | Resultado | Data |
|----|---|---|---|
| T1 | Teclado — cada tecla no Serial | ✓ Wokwi | — |
| T2 | Código 1904# abre servo | ✓ Wokwi | — |
| T3 | Auto-fecho após 8 s | ✓ Wokwi | — |
| T4 | Código errado — LED vermelho | ✓ Wokwi | — |
| T5 | Teclado físico Mauser | — | — |
| T6 | Servo na fechadura real | — | — |

## Referência

Simulação: [../simulacao/wokwi/](../simulacao/wokwi/)
