candeiassantiago393-spec/PAP/logicas_extras/estendal_inteligente/testes/README.md

# Testes — Estendal Inteligente

Registo de testes molhado/seco.

## Estado

**Pendente** — simulação Wokwi OK; testes com sensor Temu por documentar.

## Testes planeados

| ID | Teste | Resultado | Data |
|----|---|---|---|
| T1 | Slide switch HIGH → servo recolhe | ✓ Wokwi | — |
| T2 | Após 8 s servo reabre | ✓ Wokwi | — |
| T3 | Sensor Temu — gotas de água | — | — |
| T4 | Sensor seco — servo não move | — | — |
| T5 | Estendal mecânico na maquete | — | — |

## Referência

Simulação: [../simulacao/wokwi/](../simulacao/wokwi/)
