candeiassantiago393-spec/PAP/logicas_extras/central_de_controlo/testes/bancada/REGISTO_2026-07-12.md

# Registo de bancada — 12 julho 2026

Sessão de **montagem física** e validação do subsistema **ambiente** (KY-015) na **Central de Controlo** — Arduino Mega 2560 + OLED SSD1306.

## Objectivo do dia

1. Soldar e cablar o módulo **KY-015** (temperatura + humidade do ar)
2. Validar leituras no **OLED** e na Serial
3. Separar gráficos — um ecrã para **temperatura**, outro para **humidade** (em vez de um só gráfico combinado)
4. Confirmar a **lógica de humidade** (histórico + sparkline) no display

## Processo seguido

| Passo | Acção | Resultado |
|---|---|---|
| 1 | Soldadura KY-015 | Módulo **(-) GND**, **(S)** pin 2, **(+) 5V** — ligações firmes |
| 2 | Cablagem completa na bancada | Sensor + OLED (I2C 20/21) + botões NEXT/PREV prontos |
| 3 | Upload `dht_oled` | Firmware carregado na Mega — **OK** |
| 4 | Ecrã **AMBIENTE** | Temperatura e humidade visíveis no OLED + Serial (`KY-015: XX.X C \| XX.X %`) |
| 5 | Separar gráficos | **GRAF TEMP** (ecrã 2) e **GRAF HUM** (ecrã 3) — cada um com sparkline própria |
| 6 | Teste lógica humidade | Histórico de humidade actualiza a cada 2 s; linha desenha após ~4 s — **OK** |
| 7 | Navegação ecrãs | Rotação automática (5 s) e botões NEXT/PREV entre HOME → AMBIENTE → GRAF TEMP → GRAF HUM → QR |

## Alteração face à versão anterior

| Antes | Agora |
|---|---|
| Um único gráfico / ecrã partilhado para temp e hum | **Dois ecrãs dedicados:** `GRAFICO TEMP` e `GRAFICO HUM` |
| Humidade só no ecrã AMBIENTE (valor numérico) | Humidade com **valor + histórico gráfico** (mesma lógica que temperatura) |

Código: [dht_oled/src/main.ino](dht_oled/src/main.ino) — ecrãs 2 e 3 independentes.

## Hardware confirmado (Mega)

| Componente | Ligação | Estado |
|---|---|---|
| KY-015 (DHT11) | (-) GND, (S) pin 2, (+) 5V | **Soldado + testado** |
| OLED SSD1306 | SDA 20, SCL 21, 0x3C | OK |
| Botão NEXT | pin 3 ↔ GND | OK |
| Botão PREV | pin 4 ↔ GND | OK |

## Estado dos testes

| ID | Teste | Resultado | Notas |
|----|---|---|---|
| T1 | OLED + HOME | **OK** | (11 jul) |
| T2 | KY-015 temp/hum | **OK** | Serial + ecrã AMBIENTE |
| T2b | Gráfico temperatura | **OK** | Ecrã GRAF TEMP — sparkline |
| T2c | Gráfico humidade | **OK** | Ecrã GRAF HUM — sparkline + lógica histórico |
| T5 | Sensor de gás (MQ) | **Próximo** | Ver secção abaixo |

## Próximo passo — sensor de gás

| Campo | Valor |
|---|---|
| Sensor planeado | **MQ-2** ou **MQ-135** (saída analógica) |
| Teste alvo | **T5** — ecrã **FUGA DE GÁS**, barra de nível, alarme acima do limiar |
| Referência firmware | [../../sketch.ino](../../sketch.ino) / [../../src/main.cpp](../../src/main.cpp) — `readGasPercent()`, `GAS_LIMIT` |
| Pinagem ESP32 (produto final) | Entrada analógica A0 (simulação Wokwi) |
| Pinagem Mega (bancada) | A definir ao ligar módulo MQ |

### Tarefas para a próxima sessão

- [ ] Ligar módulo MQ (VCC, GND, AOUT → pin analógico Mega)
- [ ] Criar teste isolado `testes/bancada/mq_oled/` ou integrar no firmware completo Mega
- [ ] Validar barra de gás no OLED e limiar de alarme (`GAS_LIMIT = 50%`)
- [ ] Registar resultados em novo `REGISTO_YYYY-MM-DD.md`

## Comandos úteis

```powershell
cd logicas_extras/central_de_controlo/testes/bancada/dht_oled
pio run -t upload --upload-port COMx
pio device monitor -b 9600
```

## Registo anterior

[REGISTO_2026-07-11.md](REGISTO_2026-07-11.md) — primeira validação KY-015, fix `dtostrf`, botões, COM7.
