candeiassantiago393-spec/PAP/logicas_extras/central_de_controlo/testes/bancada/REGISTO_2026-07-11.md

# Registo de bancada — 11 julho 2026

Sessão de validação física da **Central de Controlo** com **Arduino Mega 2560**, sensor **KY-015** e OLED SSD1306.

## Objectivo do dia

1. Validar KY-015 + OLED na bancada (teste isolado `dht_oled`)
2. Alinhar firmware final com hardware real (KY-015 em vez de DHT22)
3. Compilar e fazer upload do **firmware completo** na Mega

## Processo seguido

| Passo | Acção | Resultado |
|---|---|---|
| 1 | Identificar sensor real | Módulo **KY-015** (DHT11 integrado), não DHT11 nu nem DHT22 |
| 2 | Actualizar teste `dht_oled` | Pinagem `(-) GND`, `(S)` pin 2, `(+)` 5V; docs e mensagens Serial/OLED |
| 3 | Upload teste isolado | Falhou — **COM7 ocupado** (várias instâncias Arduino IDE + monitor Serial) |
| 4 | Libertar COM7 | Fechar Arduino IDE / Serial Monitor; upload OK |
| 5 | Botão NEXT pin 3 | Ligação GND + pin correcta; documentar pinagem **diagonal** em botão 4 pinos |
| 6 | Actualizar firmware final | KY-015 (DHT11), pinagem ESP32 GPIO 26 |
| 7 | Suporte Mega no firmware final | `platformio.ini` env `megaatmega2560`, ficheiro `pins.h`, `#ifdef` DHTesp vs Adafruit DHT |
| 8 | Upload firmware completo Mega | `pio run -e megaatmega2560 -t upload --upload-port COM7` — **SUCCESS** |
| 9 | Leitura temp/hum | Valores correctos na Serial; no OLED aparecia **`?`** |
| 10 | Correcção display floats | `dtostrf()` na Mega — AVR não suporta `%f` em `snprintf` |

## Dificuldades encontradas

### 1. Upload — `Acesso negado` em COM7

- **Sintoma:** `cannot open port COM7: Acesso negado`, `stk500v2_getsync() failed`
- **Causa:** Porta serial bloqueada por Arduino IDE (várias instâncias), monitor Serial ou `pio device monitor`
- **Solução:** Fechar tudo o que usa COM7; upload antes de abrir monitor; desligar/religar USB se necessário

### 2. Sensor errado na documentação inicial

- **Sintoma:** Doc referia DHT11 nu (4 pinos + resistor 10 kΩ)
- **Causa:** Hardware real é módulo **KY-015** (3 pinos, pull-up integrado)
- **Solução:** Actualizar código, README e pinagem; firmware final passou de DHT22 para DHT11/KY-015

### 3. Botão não respondia

- **Sintoma:** NEXT ligado a GND + pin 3 sem efeito
- **Causa provável:** Botão táctil 4 pinos — fios no **mesmo lado** (não fecha circuito ao premir)
- **Solução:** Pinagem em diagonal (ex.: pin 1 → Mega 3, pin 3 → GND); indicador `N:0/1` no ecrã HOME para debug

### 4. Temperatura com `?` no OLED (Mega)

- **Sintoma:** Serial mostrava `24.5 C` correctamente; OLED `Temperatura: ? C`
- **Causa:** Em AVR (Mega), `snprintf(..., "%.1f", float)` **não funciona** — printf float não linkado por defeito
- **Solução:** Função `floatToStr()` com `dtostrf()` antes de `display.print()`

### 5. Dois targets no mesmo código

- **Desafio:** ESP32 usa DHTesp + GPIO diferentes; Mega usa Adafruit DHT + pinagem da bancada
- **Solução:** `pins.h` + `#if defined(ARDUINO_AVR_MEGA2560)` para biblioteca, pinos e formatação numérica

## Hardware confirmado (Mega)

| Componente | Ligação |
|---|---|
| OLED SSD1306 | SDA 20, SCL 21, 0x3C |
| KY-015 | (-) GND, (S) pin 2, (+) 5V |
| Botão NEXT | pin 3 ↔ GND (INPUT_PULLUP) |
| Botão OK | pin 4 ↔ GND |

## Comandos úteis

```powershell
# Teste isolado
cd logicas_extras/central_de_controlo/testes/bancada/dht_oled
pio run -t upload --upload-port COM7
pio device monitor --port COM7

# Firmware completo (Mega)
cd logicas_extras/central_de_controlo
pio run -e megaatmega2560 -t upload --upload-port COM7
pio device monitor --port COM7 -b 115200
```

## Estado dos testes

| ID | Teste | Resultado | Notas |
|----|---|---|---|
| T1 | OLED + HOME | **OK** | Branding visível |
| T2 | KY-015 temp/hum | **OK** | Serial + OLED após fix `dtostrf` |
| T3–T8 | Restantes subsistemas | Pendente | Requer sensores adicionais na Mega |

## Próximos passos

- [ ] Validar botões NEXT/OK no firmware completo (modo feira + navegação)
- [ ] Ligar PIR, LEDs, potenciómetros/sensores analógicos (A0–A3)
- [ ] Montagem final em ESP32 na caixa física
