candeiassantiago393-spec/PAP/logicas_extras/cartoes_predio/testes/README.md

# Testes — Cartões de Prédio

Registo de testes na bancada e na maquete.

## Estado

**Pendente** — documentar resultados quando montar o hardware.

## Testes planeados

| ID | Teste | Resultado | Data |
|----|---|---|---|
| T1 | Leitura UID cartão A | — | — |
| T2 | Leitura UID cartão B | — | — |
| T3 | Cartão autorizado abre fechadura | — | — |
| T4 | Cartão desconhecido nega acesso | — | — |
| T5 | Dois cartões seguidos (cooldown) | — | — |

## Referência

Pinagem: [../documentacao/pinagem.md](../documentacao/pinagem.md)
