candeiassantiago393-spec/PAP/elevador/testes/bancada/legacy/README.md

# Testes bancada — legacy

Testes substituídos ou duplicados — mantidos só como referência histórica.

| Pasta | Motivo |
|---|---|
| [integrado/](integrado/) | Integração Hall+OLED+botões — substituído por testes isolados + firmware maquete |
| [elevador_ext/](elevador_ext/) | Rascunho elevador exterior — substituído por [codigo_final_3_0_maquete/ext_porta](../../../real/codigo_final_3_0_maquete/ext_porta/) |

Voltar: [../README.md](../README.md)
