candeiassantiago393-spec/PAP/docs/relatorios/tinkercad/Elevador_PaP_v01.pdf

A

1 | 2 | 3 | 4 | 5 | 6

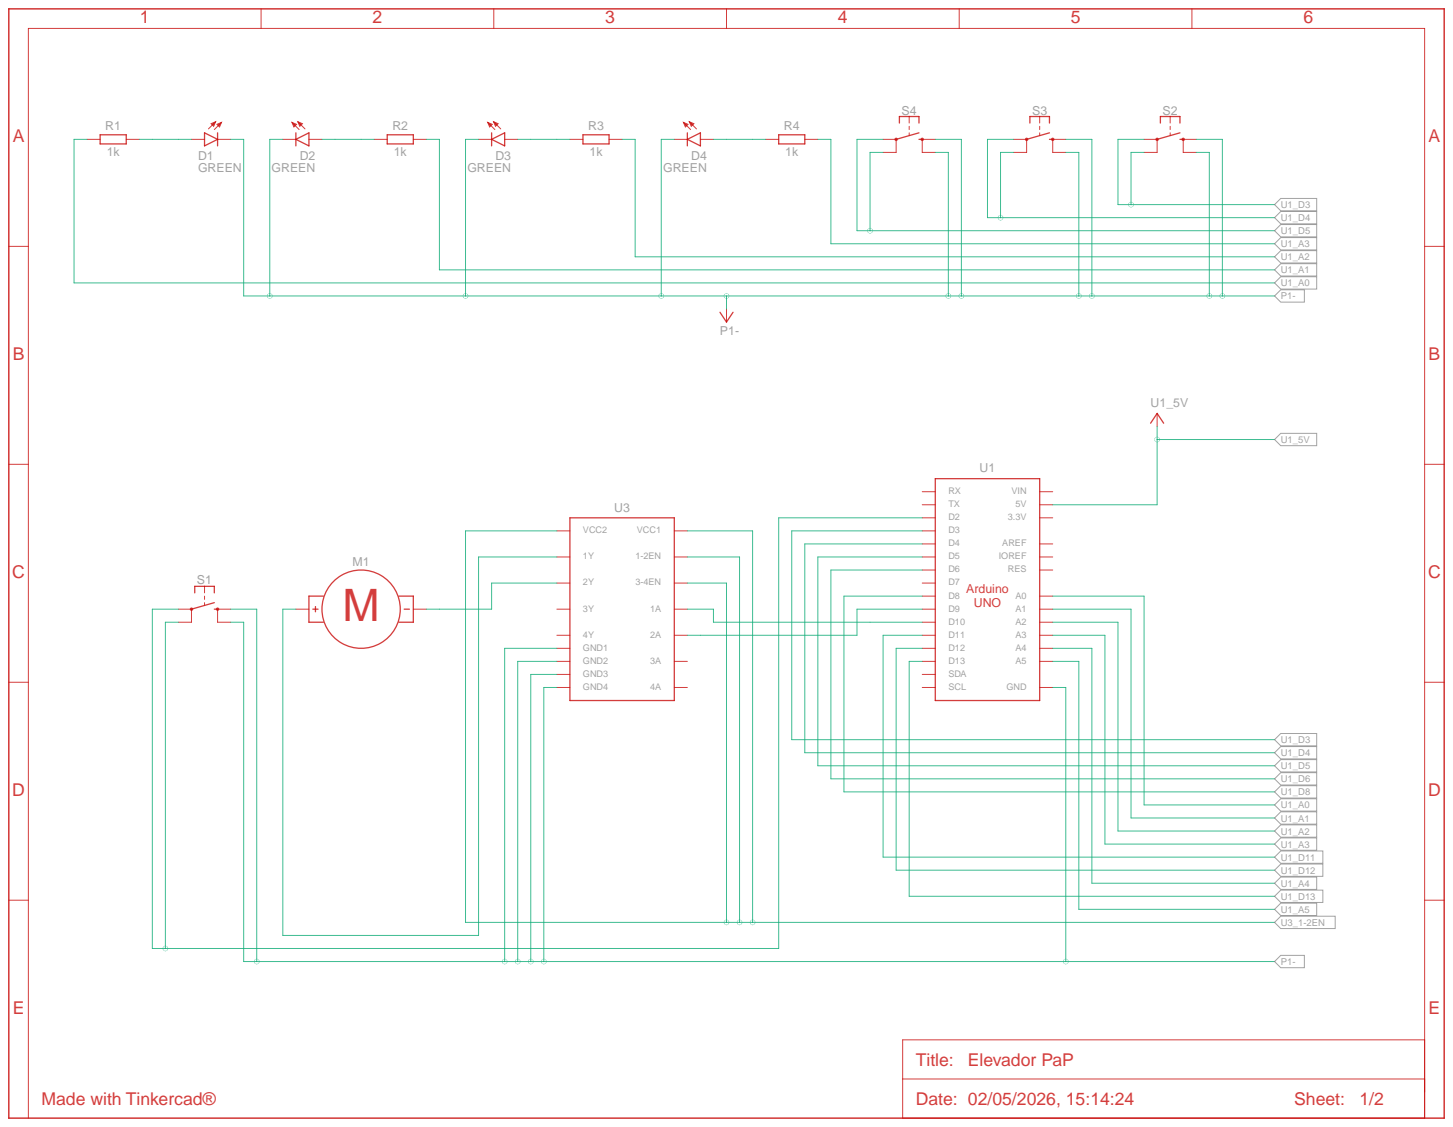
[picture p14: page 1]

A

1 | 2 | 3 | 4 | 5 | 6

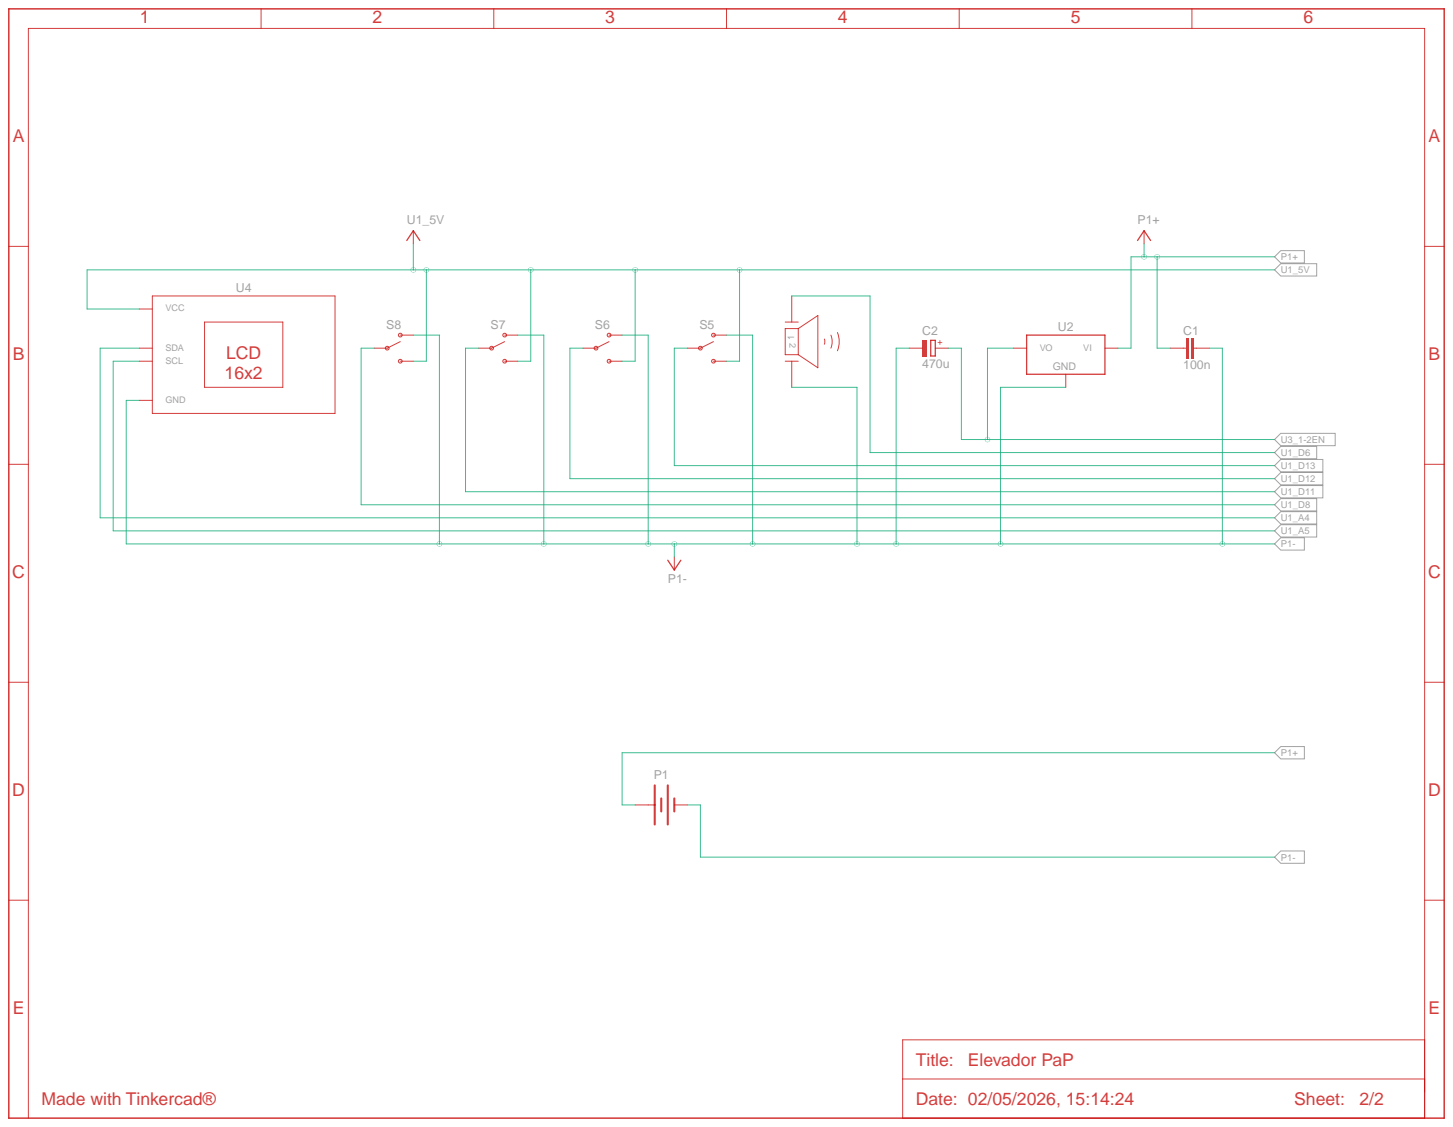
[picture p15: page 2]
Date: 02/05/2026, 15:14:24; Sheet: 2/2; VCC; SDA SCL; GND; LCD 16x2

Title: Elevador PaP

Made with Tinkercad®
