candeiassantiago393-spec/PAP/logicas_extras/central_de_controlo/src/main.cpp

#include <Adafruit_GFX.h>
#include <Adafruit_SSD1306.h>
#include <Wire.h>
#include "pins.h"

#if defined(ARDUINO_AVR_MEGA2560)
#include <DHT.h>
#define DHTTYPE DHT11
#else
#include <DHTesp.h>
#endif

#define SCREEN_WIDTH 128
#define SCREEN_HEIGHT 64
#define OLED_ADDR 0x3C
#define OLED_RESET -1

// Estufa v1.3
#define GAS_LIMIT 50           // % acima do qual dispara o alarme de gas
#define GAS_ALARM_BLINK_MS 250

// Sensor de gas (MQ-2/MQ-135) — saida analogica simulada por potenciometro
#define FIRE_LIMIT 50          // % acima do qual dispara o alarme de fogo
#define FIRE_ALARM_BLINK_MS 150

// Sensor de fogo/chama (KY-026 IR) — saida analogica (intensidade)
#define QUAKE_LIMIT 50         // % acima do qual dispara o alarme de sismo
#define QUAKE_ALARM_BLINK_MS 120

#define SOIL_LIMIT_LOW 30
#define SOIL_LIMIT_HIGH 70
#define GREENHOUSE_INTERVAL_MS 1000
#define GREEN_LED_BLINK_MS 300
#define PUMP_MAX_ON_MS 10000
#define PUMP_PAUSE_MS 30000
#define ALARM_LED_BLINK_MS 200

#define DEBOUNCE_MS 35
#define PIR_COOLDOWN_MS 30000
#define FEIRA_INTERVAL_MS 5000
#define FEIRA_IDLE_MS 120000

#define SPARK_LEN 48
#define SPARK_X 4
#define SPARK_Y 14
#define SPARK_W 120
#define SPARK_H 42

// QR 31x31 — https://www.instagram.com/candeias.dev
#define QR_W 31
#define QR_H 31
const uint8_t PROGMEM instagramQr[] = {
  0x00, 0x00, 0x00, 0x00, 0x7F, 0x7C, 0x5D, 0xFC, 0x41, 0x5C, 0x05, 0x04,
  0x5D, 0x07, 0x15, 0x74, 0x5D, 0x6B, 0xA9, 0x74, 0x5D, 0x38, 0xCD, 0x74,
  0x41, 0x2D, 0x7D, 0x04, 0x7F, 0x55, 0x55, 0xFC, 0x00, 0x71, 0xF0, 0x00,
  0x5B, 0xBE, 0xF1, 0x2C, 0x6E, 0x1E, 0x3F, 0xC4, 0x17, 0x8A, 0x71, 0xD8,
  0x70, 0x6C, 0xDB, 0xC4, 0x69, 0xB9, 0xF0, 0x30, 0x14, 0xA1, 0xC9, 0x9C,
  0x7B, 0x12, 0x3A, 0xDC, 0x02, 0x09, 0x8B, 0xC8, 0x1D, 0x95, 0x12, 0x68,
  0x26, 0x75, 0x86, 0xB8, 0x45, 0xAF, 0xF6, 0x90, 0x16, 0xFB, 0x3B, 0x10,
  0x3D, 0x6F, 0xFF, 0xF0, 0x00, 0x44, 0x54, 0x7C, 0x7F, 0x75, 0x6D, 0x68,
  0x41, 0x57, 0x14, 0x60, 0x5D, 0x34, 0xA7, 0xD0, 0x5D, 0x60, 0xCE, 0x64,
  0x5D, 0x55, 0x7A, 0x94, 0x41, 0x0D, 0xD4, 0xA8, 0x7F, 0x5C, 0x1C, 0x28,
  0x00, 0x00, 0x00, 0x00,
};

Adafruit_SSD1306 display(SCREEN_WIDTH, SCREEN_HEIGHT, &Wire, OLED_RESET);
#if defined(ARDUINO_AVR_MEGA2560)
DHT dhtSensor(PIN_DHT, DHTTYPE);
#else
DHTesp dhtSensor;
#endif

enum ScreenId {
  SCREEN_HOME = 0,
  SCREEN_ENV = 1,
  SCREEN_MOTION = 2,
  SCREEN_PLANTAS = 3,
  SCREEN_GAS = 4,
  SCREEN_FIRE = 5,
  SCREEN_QUAKE = 6,
  SCREEN_GRAPH = 7,
  SCREEN_INSTAGRAM = 8,
  SCREEN_COUNT = 9
};

ScreenId currentScreen = SCREEN_HOME;
ScreenId previousScreen = SCREEN_HOME;

bool isTransitioning = false;
int transitionOffset = 0;
const int transitionStep = 16;
const int transitionIntervalMs = 20;
unsigned long lastTransitionTick = 0;

bool alertActive = false;

int gasPercent = 0;
bool gasAlert = false;
unsigned long lastGasBlinkMs = 0;
bool gasBlinkState = false;

int firePercent = 0;
bool fireAlert = false;
unsigned long lastFireBlinkMs = 0;
bool fireBlinkState = false;

int quakePercent = 0;
bool quakeAlert = false;
unsigned long lastQuakeBlinkMs = 0;
bool quakeBlinkState = false;

float envTemp = NAN;
float envHum = NAN;
unsigned long lastEnvTick = 0;

float tempHistory[SPARK_LEN];
uint8_t tempHistoryIdx = 0;
uint8_t tempHistoryCount = 0;

int soilPercent = 0;
const char *soilState = "----";
bool pumpOn = false;
bool pumpRunning = false;
int pumpSecondsLeft = 0;
unsigned long pumpStartedMs = 0;
unsigned long pumpPauseUntilMs = 0;
bool soilBuzzerOn = false;
unsigned long lastGreenhouseTick = 0;
unsigned long lastGreenBlinkMs = 0;
bool greenBlinkState = false;
unsigned long lastAlarmLedBlinkMs = 0;
bool alarmLedOn = false;

bool btnNextLastRaw = HIGH;
bool btnNextStable = HIGH;
unsigned long btnNextLastChangeMs = 0;

bool btnOkLastRaw = HIGH;
bool btnOkStable = HIGH;
unsigned long btnOkLastChangeMs = 0;

bool pirLast = LOW;
unsigned long pirNextAllowedMs = 0;

bool feiraMode = true;
unsigned long lastFeiraStepMs = 0;
unsigned long lastButtonActivityMs = 0;

void setBuzzer(bool on) {
  if (on) {
    noTone(PIN_BUZZER);
    digitalWrite(PIN_BUZZER, HIGH);
  } else {
    digitalWrite(PIN_BUZZER, LOW);
    noTone(PIN_BUZZER);
  }
}

// AVR (Mega): libc nao inclui %f no printf — dtostrf evita "?" no OLED
void floatToStr(char *out, size_t outLen, float value, uint8_t decimals) {
  if (outLen == 0) return;
#if defined(ARDUINO_AVR_MEGA2560)
  char tmp[16];
  dtostrf(value, 0, decimals, tmp);
  const char *p = tmp;
  while (*p == ' ') p++;
  strncpy(out, p, outLen - 1);
  out[outLen - 1] = '\0';
#else
  if (decimals == 0) {
    snprintf(out, outLen, "%.0f", (double)value);
  } else {
    snprintf(out, outLen, "%.1f", (double)value);
  }
#endif
}

void drawHeader(const char *title, int xOffset) {
  display.setTextSize(1);
  display.setTextColor(SSD1306_WHITE);
  display.setCursor(2 + xOffset, 0);
  display.print(title);
  display.drawLine(0 + xOffset, 10, 127 + xOffset, 10, SSD1306_WHITE);
}

void drawHomeScreen(int xOffset) {
  drawHeader("HOME", xOffset);
  display.setTextSize(1);
  display.setCursor(22 + xOffset, 22);
  display.print("candeias.dev");
  display.setCursor(46 + xOffset, 38);
  display.print("studio");
}

void drawEnvScreen(int xOffset) {
  char line[32];
  drawHeader("AMBIENTE", xOffset);
  display.setTextSize(1);

  if (isnan(envTemp) || isnan(envHum)) {
    display.setCursor(4 + xOffset, 24);
    display.print("A ler KY-015...");
    display.setCursor(4 + xOffset, 38);
    display.print("Aguarde 2s");
    return;
  }

  char tStr[8];
  char hStr[8];
  floatToStr(tStr, sizeof(tStr), envTemp, 1);
  floatToStr(hStr, sizeof(hStr), envHum, 1);
  snprintf(line, sizeof(line), "Temperatura: %s C", tStr);
  display.setCursor(4 + xOffset, 20);
  display.print(line);

  snprintf(line, sizeof(line), "Humidade:    %s %%", hStr);
  display.setCursor(4 + xOffset, 34);
  display.print(line);
}

void drawMotionScreen(int xOffset) {
  char line[24];
  drawHeader("MOVIMENTO", xOffset);
  display.setTextSize(1);
  display.setCursor(4 + xOffset, 18);
  display.print("Sensor PIR ativo");

  int cooldownSec = 0;
  if (millis() < pirNextAllowedMs) {
    cooldownSec = (pirNextAllowedMs - millis() + 999) / 1000;
  }

  if (cooldownSec > 0) {
    snprintf(line, sizeof(line), "Cooldown: %ds", cooldownSec);
    display.setCursor(4 + xOffset, 32);
    display.print(line);
    display.setCursor(4 + xOffset, 46);
    display.print("Aguarda p/ rearmar");
  } else {
    display.setCursor(4 + xOffset, 36);
    display.print("Aguardando deteccao");
  }
}

void drawTextCenteredAt(int centerX, int y, const char *text) {
  display.setTextSize(1);
  int16_t x1, y1;
  uint16_t w, h;
  display.getTextBounds(text, 0, y, &x1, &y1, &w, &h);
  display.setCursor(centerX - (w / 2), y);
  display.print(text);
}

void drawTextRight(int xOffset, int y, const char *text) {
  display.setTextSize(1);
  int16_t x1, y1;
  uint16_t w, h;
  display.getTextBounds(text, 0, y, &x1, &y1, &w, &h);
  display.setCursor(124 + xOffset - w, y);
  display.print(text);
}

void drawSoilBar(int x, int y, int w, int h, int percent) {
  display.drawRect(x, y, w, h, SSD1306_WHITE);
  int innerW = w - 2;
  int fillW = map(constrain(percent, 0, 100), 0, 100, 0, innerW);
  if (fillW > 0) {
    display.fillRect(x + 1, y + 1, fillW, h - 2, SSD1306_WHITE);
  }
  int markLow = x + 1 + (innerW * SOIL_LIMIT_LOW) / 100;
  int markHigh = x + 1 + (innerW * SOIL_LIMIT_HIGH) / 100;
  display.drawFastVLine(markLow, y + h, 3, SSD1306_WHITE);
  display.drawFastVLine(markHigh, y + h, 3, SSD1306_WHITE);
}

void pushTempSample(float temp) {
  if (isnan(temp)) return;
  tempHistory[tempHistoryIdx] = temp;
  tempHistoryIdx = (tempHistoryIdx + 1) % SPARK_LEN;
  if (tempHistoryCount < SPARK_LEN) tempHistoryCount++;
}

float tempHistoryAt(uint8_t age) {
  if (tempHistoryCount < SPARK_LEN) {
    return tempHistory[age];
  }
  return tempHistory[(tempHistoryIdx + age) % SPARK_LEN];
}

void drawGraphScreen(int xOffset) {
  char line[24];
  const int gx = SPARK_X + xOffset;
  const int gy = SPARK_Y;
  const int innerW = SPARK_W - 2;
  const int innerH = SPARK_H - 2;

  drawHeader("GRAFICO", xOffset);
  display.drawRect(gx, gy, SPARK_W, SPARK_H, SSD1306_WHITE);

  if (tempHistoryCount < 2) {
    display.setCursor(gx + 18, gy + 16);
    display.print("A recolher...");
    if (!isnan(envTemp)) {
      char tStr[8];
      floatToStr(tStr, sizeof(tStr), envTemp, 1);
      snprintf(line, sizeof(line), "Atual: %s C", tStr);
      display.setCursor(gx + 18, gy + 28);
      display.print(line);
    }
    return;
  }

  float minT = tempHistoryAt(0);
  float maxT = tempHistoryAt(0);
  for (uint8_t i = 1; i < tempHistoryCount; i++) {
    float v = tempHistoryAt(i);
    if (v < minT) minT = v;
    if (v > maxT) maxT = v;
  }
  if ((maxT - minT) < 1.0f) {
    minT -= 0.5f;
    maxT += 0.5f;
  }

  const int plotX = gx + 1;
  const int plotY = gy + 1;
  int prevPx = -1;
  int prevPy = -1;

  for (uint8_t i = 0; i < tempHistoryCount; i++) {
    float v = tempHistoryAt(i);
    int px = plotX;
    if (tempHistoryCount > 1) {
      px = plotX + (i * innerW) / (tempHistoryCount - 1);
    }
    int py = plotY + innerH - 1 - (int)((v - minT) * innerH / (maxT - minT));
    py = constrain(py, plotY, plotY + innerH - 1);

    if (prevPx >= 0) {
      display.drawLine(prevPx, prevPy, px, py, SSD1306_WHITE);
    } else {
      display.drawPixel(px, py, SSD1306_WHITE);
    }
    prevPx = px;
    prevPy = py;
  }

  char minStr[8];
  char maxStr[8];
  floatToStr(minStr, sizeof(minStr), minT, 0);
  floatToStr(maxStr, sizeof(maxStr), maxT, 0);
  snprintf(line, sizeof(line), "Min:%s Max:%s", minStr, maxStr);
  display.setCursor(gx + 2, gy + SPARK_H + 2);
  display.print(line);

  if (!isnan(envTemp)) {
    char tStr[8];
    floatToStr(tStr, sizeof(tStr), envTemp, 1);
    snprintf(line, sizeof(line), "%s C", tStr);
    drawTextRight(xOffset, gy + SPARK_H + 2, line);
  }
}

void drawInstagramScreen(int xOffset) {
  const int qrX = (SCREEN_WIDTH - QR_W) / 2 + xOffset;
  const int qrY = 6;
  display.drawBitmap(qrX, qrY, instagramQr, QR_W, QR_H, SSD1306_WHITE);
  drawTextCenteredAt(64 + xOffset, 44, "@candeias.dev");
  drawTextCenteredAt(64 + xOffset, 56, "Instagram");
}

void drawPlantasScreen(int xOffset) {
  char line[28];
  const int barX = 4 + xOffset;
  const int barY = 14;
  const int barW = 120;
  const int barH = 8;
  const int innerW = barW - 2;
  const int markLowX = barX + 1 + (innerW * SOIL_LIMIT_LOW) / 100;
  const int markHighX = barX + 1 + (innerW * SOIL_LIMIT_HIGH) / 100;

  display.setTextSize(1);
  display.setTextColor(SSD1306_WHITE);

  display.setCursor(4 + xOffset, 0);
  display.print("Hum.solo");

  display.drawLine(4 + xOffset, 10, 124 + xOffset, 10, SSD1306_WHITE);

  drawSoilBar(barX, barY, barW, barH, soilPercent);

  snprintf(line, sizeof(line), "%d", SOIL_LIMIT_LOW);
  drawTextCenteredAt(markLowX, barY + barH + 4, line);
  snprintf(line, sizeof(line), "%d", SOIL_LIMIT_HIGH);
  drawTextCenteredAt(markHighX, barY + barH + 4, line);

  display.setCursor(4 + xOffset, 38);
  display.print("Estado: ");
  display.print(soilState);
  snprintf(line, sizeof(line), "%d%%", soilPercent);
  drawTextRight(xOffset, 38, line);

  display.setCursor(4 + xOffset, 50);
  if (pumpOn) {
    snprintf(line, sizeof(line), "Bomba: ON (%ds)", pumpSecondsLeft);
    display.print(line);
  } else if (soilPercent < SOIL_LIMIT_LOW && millis() < pumpPauseUntilMs) {
    int pauseSec = (pumpPauseUntilMs - millis() + 999) / 1000;
    if (pauseSec > 0) {
      snprintf(line, sizeof(line), "Bomba: OFF (%ds)", pauseSec);
      display.print(line);
    } else {
      display.print("Bomba:  OFF");
    }
  } else {
    display.print("Bomba:  OFF");
  }
}

void drawGasScreen(int xOffset) {
  char line[28];
  const int barX = 4 + xOffset;
  const int barY = 22;
  const int barW = 120;
  const int barH = 10;
  const int innerW = barW - 2;
  const int markX = barX + 1 + (innerW * GAS_LIMIT) / 100;

  drawHeader("GAS", xOffset);

  display.setTextSize(1);
  display.setCursor(4 + xOffset, 14);
  display.print("Nivel de gas");

  display.drawRect(barX, barY, barW, barH, SSD1306_WHITE);
  int fillW = map(constrain(gasPercent, 0, 100), 0, 100, 0, innerW);
  if (fillW > 0) display.fillRect(barX + 1, barY + 1, fillW, barH - 2, SSD1306_WHITE);
  display.drawFastVLine(markX, barY + barH, 3, SSD1306_WHITE);

  snprintf(line, sizeof(line), "%d%%", gasPercent);
  drawTextRight(xOffset, 40, line);

  snprintf(line, sizeof(line), "Limite %d%%", GAS_LIMIT);
  display.setCursor(4 + xOffset, 40);
  display.print(line);

  display.setCursor(4 + xOffset, 52);
  display.print("Estado: ");
  display.print(gasPercent >= GAS_LIMIT ? "FUGA!" : "OK");
}

void drawFireScreen(int xOffset) {
  char line[28];
  const int barX = 4 + xOffset;
  const int barY = 22;
  const int barW = 120;
  const int barH = 10;
  const int innerW = barW - 2;
  const int markX = barX + 1 + (innerW * FIRE_LIMIT) / 100;

  drawHeader("FOGO", xOffset);

  display.setTextSize(1);
  display.setCursor(4 + xOffset, 14);
  display.print("Intensidade");

  display.drawRect(barX, barY, barW, barH, SSD1306_WHITE);
  int fillW = map(constrain(firePercent, 0, 100), 0, 100, 0, innerW);
  if (fillW > 0) display.fillRect(barX + 1, barY + 1, fillW, barH - 2, SSD1306_WHITE);
  display.drawFastVLine(markX, barY + barH, 3, SSD1306_WHITE);

  snprintf(line, sizeof(line), "%d%%", firePercent);
  drawTextRight(xOffset, 40, line);

  snprintf(line, sizeof(line), "Limite %d%%", FIRE_LIMIT);
  display.setCursor(4 + xOffset, 40);
  display.print(line);

  display.setCursor(4 + xOffset, 52);
  display.print("Estado: ");
  display.print(firePercent >= FIRE_LIMIT ? "FOGO!" : "OK");
}

void drawQuakeScreen(int xOffset) {
  char line[28];
  const int barX = 4 + xOffset;
  const int barY = 22;
  const int barW = 120;
  const int barH = 10;
  const int innerW = barW - 2;
  const int markX = barX + 1 + (innerW * QUAKE_LIMIT) / 100;

  drawHeader("SISMO", xOffset);

  display.setTextSize(1);
  display.setCursor(4 + xOffset, 14);
  display.print("Intensidade");

  display.drawRect(barX, barY, barW, barH, SSD1306_WHITE);
  int fillW = map(constrain(quakePercent, 0, 100), 0, 100, 0, innerW);
  if (fillW > 0) display.fillRect(barX + 1, barY + 1, fillW, barH - 2, SSD1306_WHITE);
  display.drawFastVLine(markX, barY + barH, 3, SSD1306_WHITE);

  snprintf(line, sizeof(line), "%d%%", quakePercent);
  drawTextRight(xOffset, 40, line);

  snprintf(line, sizeof(line), "Limite %d%%", QUAKE_LIMIT);
  display.setCursor(4 + xOffset, 40);
  display.print(line);

  display.setCursor(4 + xOffset, 52);
  display.print("Estado: ");
  display.print(quakePercent >= QUAKE_LIMIT ? "SISMO!" : "OK");
}

void drawScreenDots(ScreenId active) {
  const int y = 3;
  const int spacing = 5;
  int cx = SCREEN_WIDTH - 4;

  for (int i = SCREEN_COUNT - 1; i >= 0; i--) {
    if (i == active) {
      display.fillCircle(cx, y, 1, SSD1306_WHITE);
    } else {
      display.drawCircle(cx, y, 1, SSD1306_WHITE);
    }
    cx -= spacing;
  }
}

void drawCenteredText(int y, const char *text, uint8_t textSize) {
  display.setTextSize(textSize);
  int16_t x1, y1;
  uint16_t w, h;
  display.getTextBounds(text, 0, y, &x1, &y1, &w, &h);
  display.setCursor((SCREEN_WIDTH - w) / 2, y);
  display.print(text);
}

void drawIntruderAlert() {
  display.clearDisplay();
  display.drawRect(2, 2, SCREEN_WIDTH - 4, SCREEN_HEIGHT - 4, SSD1306_WHITE);

  drawCenteredText(6, "ALERTA", 1);
  display.drawLine(8, 17, SCREEN_WIDTH - 8, 17, SSD1306_WHITE);

  drawCenteredText(24, "Intruso", 2);
  drawCenteredText(44, "detetado", 1);

  display.drawLine(8, 52, SCREEN_WIDTH - 8, 52, SSD1306_WHITE);
  drawCenteredText(55, "OK: silenciar", 1);

  display.display();
}

void drawGasAlert() {
  char line[20];
  display.clearDisplay();
  display.drawRect(2, 2, SCREEN_WIDTH - 4, SCREEN_HEIGHT - 4, SSD1306_WHITE);

  drawCenteredText(6, "!! AVISO !!", 1);
  display.drawLine(8, 16, SCREEN_WIDTH - 8, 16, SSD1306_WHITE);

  // Mensagem principal a piscar para chamar a atencao
  if (gasBlinkState) {
    drawCenteredText(22, "FUGA DE", 2);
    drawCenteredText(40, "GAS!!", 2);
  } else {
    drawCenteredText(31, "FUGA DE GAS!!", 1);
  }

  snprintf(line, sizeof(line), "Nivel: %d%%", gasPercent);
  drawCenteredText(54, line, 1);

  display.display();
}

void drawFireAlert() {
  char line[20];
  display.clearDisplay();
  display.drawRect(2, 2, SCREEN_WIDTH - 4, SCREEN_HEIGHT - 4, SSD1306_WHITE);

  drawCenteredText(6, "!! PERIGO !!", 1);
  display.drawLine(8, 16, SCREEN_WIDTH - 8, 16, SSD1306_WHITE);

  // Mensagem principal a piscar para chamar a atencao
  if (fireBlinkState) {
    drawCenteredText(22, "FOGO!!", 2);
    drawCenteredText(40, "INCENDIO", 2);
  } else {
    drawCenteredText(31, "FOGO / INCENDIO", 1);
  }

  snprintf(line, sizeof(line), "Nivel: %d%%", firePercent);
  drawCenteredText(54, line, 1);

  display.display();
}

void drawQuakeAlert() {
  char line[20];
  display.clearDisplay();
  display.drawRect(2, 2, SCREEN_WIDTH - 4, SCREEN_HEIGHT - 4, SSD1306_WHITE);

  drawCenteredText(6, "!! PERIGO !!", 1);
  display.drawLine(8, 16, SCREEN_WIDTH - 8, 16, SSD1306_WHITE);

  // Mensagem principal a piscar para chamar a atencao
  if (quakeBlinkState) {
    drawCenteredText(22, "SISMO!!", 2);
    drawCenteredText(40, "TERRAMOTO", 1);
  } else {
    drawCenteredText(31, "SISMO / TERRAMOTO", 1);
  }

  snprintf(line, sizeof(line), "Nivel: %d%%", quakePercent);
  drawCenteredText(54, line, 1);

  display.display();
}

void drawScreen(ScreenId screen, int xOffset) {
  switch (screen) {
    case SCREEN_HOME:
      drawHomeScreen(xOffset);
      break;
    case SCREEN_ENV:
      drawEnvScreen(xOffset);
      break;
    case SCREEN_MOTION:
      drawMotionScreen(xOffset);
      break;
    case SCREEN_PLANTAS:
      drawPlantasScreen(xOffset);
      break;
    case SCREEN_GRAPH:
      drawGraphScreen(xOffset);
      break;
    case SCREEN_GAS:
      drawGasScreen(xOffset);
      break;
    case SCREEN_FIRE:
      drawFireScreen(xOffset);
      break;
    case SCREEN_QUAKE:
      drawQuakeScreen(xOffset);
      break;
    case SCREEN_INSTAGRAM:
      drawInstagramScreen(xOffset);
      break;
    default:
      break;
  }
}

void silenceAlarm() {
  alertActive = false;
  alarmLedOn = false;
  digitalWrite(PIN_LED_RED, LOW);
  pirNextAllowedMs = millis() + PIR_COOLDOWN_MS;
  setBuzzer(false);
}

void noteButtonActivity() {
  feiraMode = false;
  lastButtonActivityMs = millis();
}

void startTransitionTo(ScreenId next) {
  if (isTransitioning || alertActive) return;
  previousScreen = currentScreen;
  currentScreen = next;
  transitionOffset = 0;
  lastTransitionTick = millis();
  isTransitioning = true;
}

void updateFeiraMode() {
  if (alertActive || isTransitioning) return;

  unsigned long now = millis();

  if (!feiraMode && (now - lastButtonActivityMs >= FEIRA_IDLE_MS)) {
    feiraMode = true;
    lastFeiraStepMs = now;
  }

  if (feiraMode && (now - lastFeiraStepMs >= FEIRA_INTERVAL_MS)) {
    ScreenId next = static_cast<ScreenId>((currentScreen + 1) % SCREEN_COUNT);
    startTransitionTo(next);
    lastFeiraStepMs = now;
  }
}

void updateTransition() {
  if (!isTransitioning) return;

  unsigned long now = millis();
  if (now - lastTransitionTick < transitionIntervalMs) return;

  lastTransitionTick = now;
  transitionOffset += transitionStep;
  if (transitionOffset >= SCREEN_WIDTH) {
    transitionOffset = SCREEN_WIDTH;
    isTransitioning = false;
  }
}

void updateAlarmBuzzer() {
  if (fireAlert) {
    setBuzzer(true);
  } else if (quakeAlert) {
    setBuzzer(true);
  } else if (alertActive) {
    setBuzzer(true);
  } else if (gasAlert) {
    setBuzzer(true);
  } else if (!soilBuzzerOn) {
    setBuzzer(false);
  }
}

void renderUI() {
  if (fireAlert) {
    drawFireAlert();
    return;
  }

  if (quakeAlert) {
    drawQuakeAlert();
    return;
  }

  if (alertActive) {
    drawIntruderAlert();
    return;
  }

  if (gasAlert) {
    drawGasAlert();
    return;
  }

  display.clearDisplay();
  if (isTransitioning) {
    drawScreen(previousScreen, -transitionOffset);
    drawScreen(currentScreen, SCREEN_WIDTH - transitionOffset);
  } else {
    drawScreen(currentScreen, 0);
    drawScreenDots(currentScreen);
  }
  display.display();
}

bool readDebouncedButtonPressed(int pin, bool &lastRaw, bool &stable, unsigned long &lastChangeMs) {
  bool raw = digitalRead(pin);
  unsigned long now = millis();

  if (raw != lastRaw) {
    lastRaw = raw;
    lastChangeMs = now;
  }

  if ((now - lastChangeMs) > DEBOUNCE_MS && raw != stable) {
    stable = raw;
    if (stable == LOW) return true;
  }
  return false;
}

void updateEnvironmentData() {
  unsigned long now = millis();
  if (now - lastEnvTick < 2000) return;
  lastEnvTick = now;

#if !defined(ARDUINO_AVR_MEGA2560)
  TempAndHumidity data = dhtSensor.getTempAndHumidity();
  envTemp = data.temperature;
  envHum = data.humidity;
#else
  for (uint8_t attempt = 0; attempt < 3; attempt++) {
    envHum = dhtSensor.readHumidity();
    envTemp = dhtSensor.readTemperature();
    if (!isnan(envTemp) && !isnan(envHum)) break;
    delay(250);
  }
#endif
  pushTempSample(envTemp);
}

int readSoilPercent() {
  int raw = analogRead(PIN_SOIL);
  int pct = map(raw, 0, ADC_MAX, 0, 100);
  return constrain(pct, 0, 100);
}

void setAllPlantOutputsLow();

int readGasPercent() {
  int raw = analogRead(PIN_GAS);
  int pct = map(raw, 0, ADC_MAX, 0, 100);
  return constrain(pct, 0, 100);
}

void updateGas() {
  gasPercent = readGasPercent();
  gasAlert = (gasPercent >= GAS_LIMIT);
}

void updateGasOutputs() {
  if (fireAlert || quakeAlert || alertActive || !gasAlert) return;
  setAllPlantOutputsLow();
  soilBuzzerOn = false;
  unsigned long now = millis();
  if (now - lastGasBlinkMs >= GAS_ALARM_BLINK_MS) {
    lastGasBlinkMs = now;
    gasBlinkState = !gasBlinkState;
    digitalWrite(PIN_LED_YELLOW, gasBlinkState ? HIGH : LOW);
  }
}

int readFirePercent() {
  int raw = analogRead(PIN_FIRE);
  int pct = map(raw, 0, ADC_MAX, 0, 100);
  return constrain(pct, 0, 100);
}

void updateFire() {
  firePercent = readFirePercent();
  fireAlert = (firePercent >= FIRE_LIMIT);
}

void updateFireOutputs() {
  if (!fireAlert) return;
  setAllPlantOutputsLow();
  soilBuzzerOn = false;
  unsigned long now = millis();
  if (now - lastFireBlinkMs >= FIRE_ALARM_BLINK_MS) {
    lastFireBlinkMs = now;
    fireBlinkState = !fireBlinkState;
    digitalWrite(PIN_LED_RED, fireBlinkState ? HIGH : LOW);
  }
}

int readQuakePercent() {
  int raw = analogRead(PIN_QUAKE);
  int pct = map(raw, 0, ADC_MAX, 0, 100);
  return constrain(pct, 0, 100);
}

void updateQuake() {
  quakePercent = readQuakePercent();
  quakeAlert = (quakePercent >= QUAKE_LIMIT);
}

void updateQuakeOutputs() {
  if (fireAlert || !quakeAlert) return;
  setAllPlantOutputsLow();
  soilBuzzerOn = false;
  unsigned long now = millis();
  if (now - lastQuakeBlinkMs >= QUAKE_ALARM_BLINK_MS) {
    lastQuakeBlinkMs = now;
    quakeBlinkState = !quakeBlinkState;
    digitalWrite(PIN_LED_GREEN, quakeBlinkState ? HIGH : LOW);
  }
}

void setAllPlantOutputsLow() {
  digitalWrite(PIN_LED_RED, LOW);
  digitalWrite(PIN_LED_YELLOW, LOW);
  digitalWrite(PIN_LED_GREEN, LOW);
  digitalWrite(PIN_PUMP, LOW);
}

void updatePumpControl(unsigned long now) {
  pumpOn = false;
  pumpSecondsLeft = 0;

  if (soilPercent >= SOIL_LIMIT_LOW) {
    pumpRunning = false;
    return;
  }

  if (pumpRunning) {
    unsigned long elapsed = now - pumpStartedMs;
    if (elapsed >= PUMP_MAX_ON_MS) {
      pumpRunning = false;
      pumpPauseUntilMs = now + PUMP_PAUSE_MS;
    } else {
      pumpOn = true;
      pumpSecondsLeft = (PUMP_MAX_ON_MS - elapsed + 999) / 1000;
      digitalWrite(PIN_PUMP, HIGH);
      return;
    }
  }

  if (now >= pumpPauseUntilMs) {
    pumpRunning = true;
    pumpStartedMs = now;
    pumpOn = true;
    pumpSecondsLeft = PUMP_MAX_ON_MS / 1000;
    digitalWrite(PIN_PUMP, HIGH);
  }
}

void updateAlarmLed() {
  if (fireAlert || quakeAlert) return;
  if (!alertActive) return;

  setAllPlantOutputsLow();

  unsigned long now = millis();
  if (now - lastAlarmLedBlinkMs >= ALARM_LED_BLINK_MS) {
    lastAlarmLedBlinkMs = now;
    alarmLedOn = !alarmLedOn;
    digitalWrite(PIN_LED_RED, alarmLedOn ? HIGH : LOW);
  }
}

void updateGreenhouseOutputs() {
  if (fireAlert || quakeAlert || alertActive || gasAlert) return;

  setAllPlantOutputsLow();
  soilBuzzerOn = false;
  noTone(PIN_BUZZER);
  digitalWrite(PIN_BUZZER, LOW);

  unsigned long now = millis();

  if (soilPercent < SOIL_LIMIT_LOW) {
    soilState = "SECO";
    digitalWrite(PIN_LED_RED, HIGH);
    updatePumpControl(now);

    if (now - lastGreenBlinkMs >= GREEN_LED_BLINK_MS) {
      lastGreenBlinkMs = now;
      greenBlinkState = !greenBlinkState;
    }
    digitalWrite(PIN_LED_GREEN, greenBlinkState ? HIGH : LOW);

    tone(PIN_BUZZER, 2000);
    soilBuzzerOn = true;
  } else if (soilPercent <= SOIL_LIMIT_HIGH) {
    soilState = "IDEAL";
    pumpRunning = false;
    pumpOn = false;
    greenBlinkState = true;
    digitalWrite(PIN_LED_GREEN, HIGH);
  } else {
    soilState = "MOLHADO";
    pumpRunning = false;
    pumpOn = false;
    digitalWrite(PIN_LED_YELLOW, HIGH);
    tone(PIN_BUZZER, 500);
    soilBuzzerOn = true;
  }
}

void updateGreenhouse() {
  unsigned long now = millis();
  if (now - lastGreenhouseTick < GREENHOUSE_INTERVAL_MS) return;
  lastGreenhouseTick = now;

  soilPercent = readSoilPercent();
  updateGreenhouseOutputs();
}

void checkMotionAlert() {
  bool pirNow = digitalRead(PIN_PIR);
  unsigned long now = millis();

  if (pirNow == HIGH && pirLast == LOW && now >= pirNextAllowedMs) {
    alertActive = true;
    pirNextAllowedMs = now + PIR_COOLDOWN_MS;
    lastAlarmLedBlinkMs = 0;
    alarmLedOn = false;
    setAllPlantOutputsLow();
    noTone(PIN_BUZZER);
  }
  pirLast = pirNow;
}

void setup() {
  pinMode(PIN_BTN_NEXT, INPUT_PULLUP);
  pinMode(PIN_BTN_OK, INPUT_PULLUP);
  pinMode(PIN_PIR, INPUT);
  pinMode(PIN_BUZZER, OUTPUT);
  pinMode(PIN_SOIL, INPUT);
  pinMode(PIN_GAS, INPUT);
  pinMode(PIN_FIRE, INPUT);
  pinMode(PIN_QUAKE, INPUT);
  pinMode(PIN_LED_RED, OUTPUT);
  pinMode(PIN_LED_YELLOW, OUTPUT);
  pinMode(PIN_LED_GREEN, OUTPUT);
  pinMode(PIN_PUMP, OUTPUT);

  setBuzzer(false);
  setAllPlantOutputsLow();
#if defined(ARDUINO_AVR_MEGA2560)
  dhtSensor.begin();
#else
  dhtSensor.setup(PIN_DHT, DHTesp::DHT11);
#endif
  delay(2000);  // KY-015 (DHT11) estabiliza ~2s apos ligar

  for (uint8_t i = 0; i < SPARK_LEN; i++) {
    tempHistory[i] = NAN;
  }

  Serial.begin(SERIAL_BAUD);

  if (!display.begin(SSD1306_SWITCHCAPVCC, OLED_ADDR)) {
    Serial.println("Falha OLED");
    while (true) delay(10);
  }
  display.clearDisplay();
  display.setTextColor(SSD1306_WHITE);

  display.setTextSize(1);
  display.setCursor(22, 22);
  display.print("candeias.dev");
  display.setCursor(46, 38);
  display.print("studio");
  display.display();
  delay(1400);

  unsigned long bootMs = millis();
  lastFeiraStepMs = bootMs;
  lastButtonActivityMs = bootMs;
  feiraMode = true;
}

void loop() {
  if (readDebouncedButtonPressed(PIN_BTN_OK, btnOkLastRaw, btnOkStable, btnOkLastChangeMs)) {
    noteButtonActivity();
    if (alertActive) {
      silenceAlarm();
      updateGreenhouseOutputs();
    }
  }

  if (readDebouncedButtonPressed(PIN_BTN_NEXT, btnNextLastRaw, btnNextStable, btnNextLastChangeMs)) {
    noteButtonActivity();
    ScreenId next = static_cast<ScreenId>((currentScreen + 1) % SCREEN_COUNT);
    startTransitionTo(next);
  }

  updateFeiraMode();
  updateTransition();
  updateEnvironmentData();
  updateGreenhouse();
  updateGas();
  updateFire();
  updateQuake();
  checkMotionAlert();
  updateAlarmLed();
  updateGasOutputs();
  updateFireOutputs();
  updateQuakeOutputs();
  updateAlarmBuzzer();
  renderUI();

  delay(5);
}
