candeiassantiago393-spec/PAP/(commit log)

2026-06-22 docs: contexto inicial, topologia segmentada e vídeo da maquete
    Estabelece a estrutura PAP (elevador + logicas_extras), documentação
    de contexto, dificuldades, guia de apresentação no Cursor e primeiro
    registo visual da montagem física.
2026-06-22 feat: migrar código legado, etapas, compras e firmware PlatformIO
    Consolida simulação v01–v06, firmware real L298N, testes de bancada,
    relatórios, faturas Mauser e documentação por etapas no repo central PAP.
2026-06-22 docs: ?ndice interligado, migra??o painel ecra e sync de tasks
    Cria mapa naveg?vel do reposit?rio, liga READMEs entre pastas, corrige encoding e integra projeto ecra em paineis_controlo.
    [gen_qr.py, main.cpp, sketch.ino]
2026-06-22 docs: clarificar ecra no PAP vs me em repo externo
    Deixa expl?cito que paineis_controlo ? o ecra migrado e que geral-controll-app fica fora do repo.
2026-06-22 feat: estado maquete jun 2026, grafico Hall A3144 e docs meteorologia
    Regista fotos/videos da montagem, motor+tambor, bug piso 3, BOM actualizado e meteorologia ligada ao painel ecra.
    [main.ino, plot_hall.py]
2026-07-06 feat: adicionar projetos painel ecra ESP32 e tranca cofre keypad
    Migrar codigo dos repos externos esp32-candeias-box (painel ecra) e Tranca-de-Cofre-com-KeyPad-Arduino para dentro do PAP em logicas_extras.
2026-07-06 feat(ecra): adicionar sensor de gas com ecra e alarme
    Novo subsistema GAS no painel ESP32: potenciometro no GPIO35 a simular sensor MQ (saida analogica), ecra GAS com barra e estado, e alarme (buzzer + LED amarelo a piscar + ecra ALERTA GAS) acima de 60%.
    [main.cpp, sketch.ino]
2026-07-06 feat(ecra): aviso FUGA DE GAS!! ao exceder o limite
    Ecra de alarme mostra mensagem grande e a piscar FUGA DE GAS!! e o estado do ecra GAS passa a FUGA! acima do limite.
2026-07-06 feat(estendal): adicionar simulacao Wokwi do toldo automatico
    Lógica do estendal por sensor de chuva (Arduino Uno + slide switch + servo) em toldo_automatico/simulacao/wokwi/, com READMEs de estado atualizados.
2026-07-06 feat(ecra): adicionar sensor de fogo com ecra e alarme prioritario
    Novo subsistema FOGO (KY-026, saida analogica simulada por potenciometro no GPIO4): ecra FOGO com barra de intensidade e estado, alarme com LED vermelho a piscar + buzzer + ecra FOGO/INCENDIO. Fogo tem prioridade sobre intruso e gas.
    [main.cpp, sketch.ino]
2026-07-06 fix(estendal): adicionar wokwi.toml em falta para simular
2026-07-06 fix(wokwi): compilar firmware Uno (cofre e estendal) via PlatformIO
    A extensao Wokwi nao compila .ino: adicionar platformio.ini (board uno + libs Servo/Keypad) e apontar wokwi.toml para .pio/build/uno/firmware.hex+elf, para os botoes/servo/LEDs funcionarem.
2026-07-06 feat(cofre): abertura/fecho suave do servo e auto-fecho apos 8s
    Codigo correto abre o servo gradualmente (for 0->90), mantem 8s aberto e fecha suavemente (for 90->0), apagando o LED verde no fim.
2026-07-06 chore: remover modulos meteorologia, porta_predio, paineis_controlo e seguranca
    Pastas removidas a pedido; README das logicas extras atualizado (painel ecra passa a referir esp32-candeias-box).
2026-07-06 refactor(logicas_extras): renomear modulos (central_de_controlo, cartoes_predio, estendal_inteligente)
    esp32-candeias-box -> central_de_controlo; rfid -> cartoes_predio; toldo_automatico -> estendal_inteligente. Cofre -> codigo_porta_predio fica pendente (pasta bloqueada por processo externo). legacy passa a ultimo por ordem alfabetica.
2026-07-06 feat(central): adicionar sensor de sismos com ecra e alarme
    Novo subsistema SISMO (sensor de vibracao SW-420, intensidade simulada por potenciometro no GPIO13): ecra SISMO com barra e estado, alarme com LED verde a piscar + buzzer + ecra SISMO/TERRAMOTO. Prioridade: fogo > sismo > intruso > gas.
    [main.cpp, sketch.ino]
2026-07-06 tweak(central): reduzir limites de alarmes e solo
    Gas, fogo e sismo: 60% -> 50%. Solo seco/ideal/molhado: 35/75 -> 30/70. Marcas do ecra PLANTAS passam a usar as constantes.
2026-07-06 docs(logicas_extras): documentacao completa de cada modulo
    README, documentacao (funcionamento + pinagem), simulacao, real e testes para cartoes_predio, central_de_controlo, cofre, estendal_inteligente e legacy. real/ e testes/ ficam como stubs para preencher na montagem.
2026-07-06 docs(real): estrutura pinagem, fotos, notas e codigo por fazer
    Actualizar README de real/ em todos os modulos com o que deve ficar na pasta, checklists Por fazer, e placeholders para pinagem definitiva, fotos, notas_montagem e firmware PlatformIO.
2026-07-06 feat(interface): integrar Candeias Control App no repositorio PAP
    Migra o codigo de tt/me para interface/, excluindo dados pessoais via .gitignore.
2026-07-08 Organizar testes de bancada e actualizar documentacao do elevador.
    Reestrutura elevador/testes/bancada com PlatformIO (src/main.ino), testes motor e integrado, e ficheiros legacy. Corrige reten??o do motor L298N ao parar, remove firmware duplicado, e renomeia cofre para codigo_predio com docs actualizadas.
    [Test_01_External_Requests_Button_LED_Latched.ino, Test_02_External_Buttons_Only.ino, Tranca_Cofre_Keypad.ino, cofre_codigo_secreto.ino, main.ino, sensorhall.ino, sketch.ino]
2026-07-08 Adicionar scripts automaticos de build e upload para testes de bancada.
    Permite compilar todos os projectos e enviar firmware ao Mega sem escolher manualmente a porta COM.
2026-07-11 Central de controlo: bancada Mega, KY-015 e registo do dia 11/07.
    Adiciona teste dht_oled, suporte Mega+ESP32 no firmware final, sensor KY-015 (DHT11), correcao dtostrf no OLED AVR, e documentacao das dificuldades (COM7, botao, ?).
2026-07-12 Organizar firmware final 3.0 e testes de bancada do elevador.
    Arquiva a versao completa congelada, adiciona variant maquete com pinagem D7-D12 e porta D22, consolida testes Hall relevantes e actualiza documentacao.
2026-07-12 Registar bancada KY-015 de 12/07: soldadura, graficos temp/hum e proximo passo gas.
    Documenta sensor de humidade e temperatura testado no OLED com ecras separados e actualiza indices de testes da central de controlo.
2026-07-13 Organizar firmware maquete ext_porta e testes KY-026 na central.
    - Move firmware activo para codigo_final_3_0_maquete/ext_porta (porta D22, Hall debounce, retenção motor, piso 1 relaxado)
    - Actualiza upload.ps1, build_all e documentação do elevador
    - Adiciona testes fire_oled e fire_serial na central de controlo
2026-07-13 Adicionar dashboard web da central, firmware bancada e guia para outro PC.
    Inclui testes DHT+gas+OLED, servidor Serial/WebSocket, run_dashboard.ps1 e versoes em real/.
2026-07-13 Simplificar arranque do dashboard com comando unico e detecao automatica da COM.
    Adiciona run_dashboard.cmd na raiz e atualiza o guia para funcionar em qualquer PC sem configurar a porta manualmente.
2026-07-13 Actualizar Smart Home Lab com firmware real v2, sensor KY-002, NEXT corrigido e dashboard com export CSV.
    Inclui teste PIR em bancada, telemetria de vibração e documentação de pinagem actualizada.
    [main.ino, server.py]
2026-07-14 feat(logicas_extras): corrigir central OLED/botoes e adicionar firmware codigo_predio.
    Melhora navegacao NEXT/PREV e layout do OLED na central de controlo; simplifica o acesso por PIN do predio para teclado 096-4642 e servo apenas.
    [Tranca_Cofre_Keypad.ino, cofre_codigo_secreto.ino, main.ino]
2026-07-15 Add KY-026 fire sensor to Central firmware and dashboard
2026-07-15 Fix dashboard fire telemetry UI and detect legacy firmware
    [main.ino, server.py]
2026-07-15 Sismo: buzzer 6s one-shot per upload; sync dashboard qb field
    [main.ino, server.py]
